pajagua/recolector-de-frutas/vision/README.md

# Visión – cámaras estéreo (PC)

```
cd vision
python -m venv .venv
.venv\Scripts\activate
pip install -r requirements.txt
python scripts/01_probar_camaras.py        # ver las dos cámaras
python scripts/02_capturar_calibracion.py  # fotos del damero para la stereo calibration
```

Índices de cámara, resolución y tamaño del damero: `config/camaras.yaml`.

| Ruta | Qué va |
|---|---|
| `src/citribot_vision/` | código reutilizable (cámaras, calibración, detección, triangulación) |
| `scripts/` | scripts numerados por etapa |
| `data/calibracion/` | resultados de la calibración (matrices) |
| `data/calibracion_imagenes/`, `data/capturas/` | fotos (Git las ignora, solo se guarda la carpeta) |

## Montaje de las cámaras

Las dos **Logitech C270** van en un mástil fijo a la base (CAD: `cad/solidworks/01_Base_J0/CB-150_Modulo_Camaras.SLDASM`, detalle en
[cad/solidworks/README.md §6.11](../cad/solidworks/README.md#611-cámaras-estéreo-cb-150--v71)). Valores nominales en `config/camaras.yaml` (`montaje`).

- Soporte **StereoVision_03** (STL en `cad/imprimir/01_Base_J0/`: base CB-156 + 2 tapas CB-157): cada C270 se cuelga con su pinza; **71 mm entre lentes**, paralelas, a ≈ 661 mm sobre el tablero y a 565 mm del centro de la esfera de trabajo. A esa distancia, en 720p la esfera queda ≈ 1° más alta que el campo vertical (se pierden ≈ 9 mm arriba y abajo): usar 640 × 480, que ve más en vertical, o verificarlo con el damero.
- Para calibrar el par estéreo alcanza con el soporte solo (no hace falta el mástil): la calibración estéreo depende únicamente de cómo quedan las cámaras entre sí. Después no hay que moverlas dentro del soporte.
- **Pose de observación del brazo**: J3 retraído y J2 = −45°. En otras poses la herramienta tapa parte de la esfera.
- Sacar las fotos con el robot quieto: las dos webcams no están sincronizadas.
- Fijar exposición y balance de blancos, y usar MJPEG o puertos USB distintos para no saturar el ancho de banda.
- Medir el campo de visión real con el damero (en 720p la C270 puede recortar el sensor; en 640 × 480 suele ver más en vertical).
- Calibración cámara → robot: damero en la brida de E3, en varias poses conocidas del brazo.
- **Pruebas sin el brazo**: la pieza CB-158 (`cad/imprimir/12_Pruebas/CB-158_Adaptador_Rotula_Bola12.stl`) trae una bola de Ø11,8 mm que entra directo en la rótula del trípode, en lugar del perno M6 original. El cuello (Ø4,8) es macizo. Usa los mismos 4 × M3x12 que el adaptador del mástil, así que después se cambia sin tocar las cámaras ni la calibración estéreo.
