pajagua/recolector-de-frutas/entregas/README.md

# Entregas parciales

Copia de lo que se entregó en cada etapa del curso. Es **historial**: no se edita. Las versiones vigentes de cada cosa están en las carpetas principales del repo.

| Carpeta | Tema | Contenido |
|---|---|---|
| `entrega_05/` | Control en lazo abierto | Sketches Arduino de la cintura, scripts MATLAB, notebook de Colab, informe `control_lazo_abierto.md` |
| `entrega_06/` | Control en lazo cerrado | Guía, modelado e identificación del motor (`DatosMotor.sid`), PID de posición y velocidad, análisis de torque de la ventosa, soporte U de la muñeca, notebook del grupo |
| `entrega_07/` | Prototipo con motores GA25-370 | Piezas modificadas del brazo Mrk1 (STL y 3MF para imprimir) |
