pajagua/recolector-de-frutas/docs/sistemas_de_referencia.md

# Sistemas de referencia del brazo (Denavit-Hartenberg)

En el CAD hay un sistema de coordenadas por articulación, con la convención de Denavit-Hartenberg estándar: **z<sub>i</sub> es el eje de la articulación i+1** y x<sub>i</sub> va por la normal común entre z<sub>i−1</sub> y z<sub>i</sub>. Cada sistema está dentro de la pieza del eslabón al que pertenece, así que se mueve con él cuando se mueven las articulaciones.

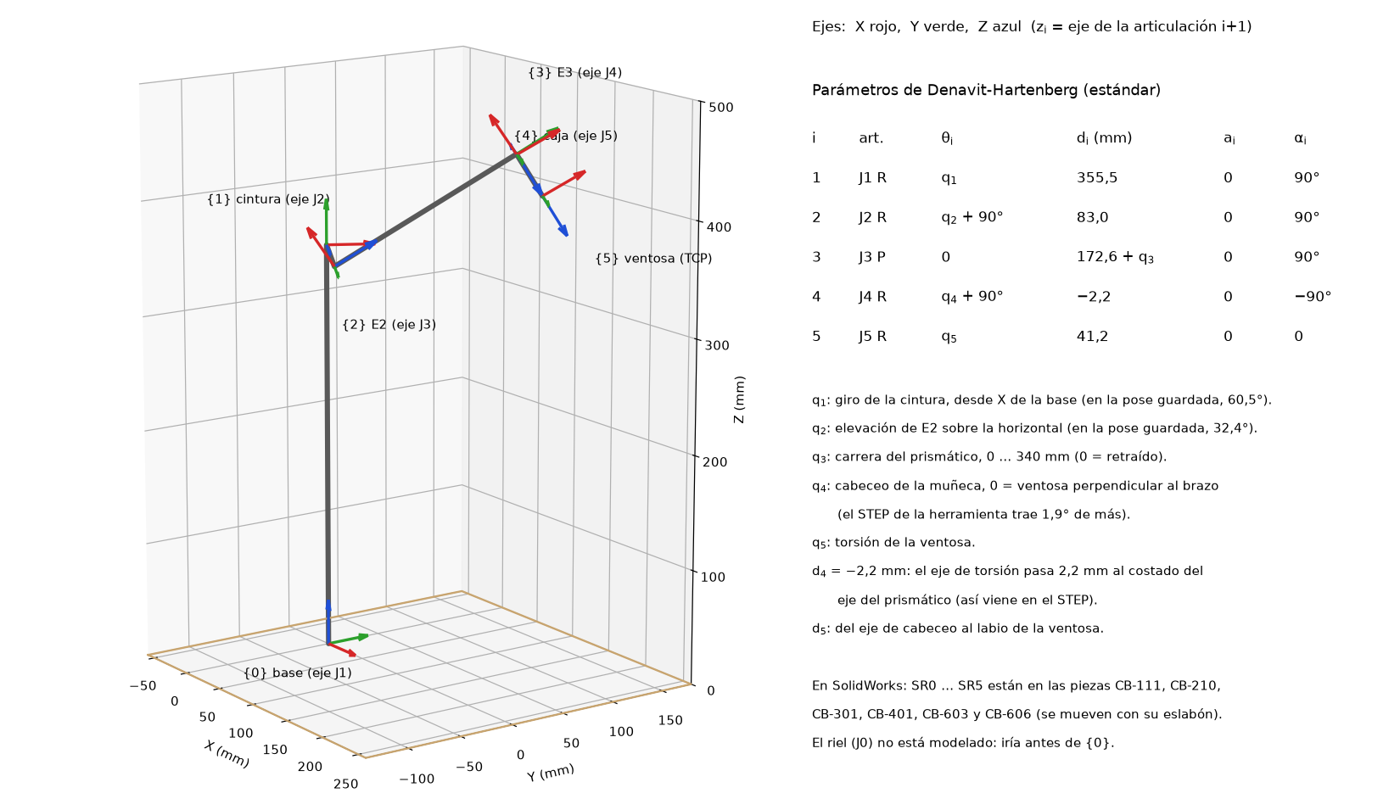
[picture p16: cad/solidworks/06_Imagenes/CB-000_Sistemas_Referencia_DH.png]
Sistemas de referencia DH


## Dónde están en SolidWorks

| Sistema | Pieza (eslabón) | z | Origen |
|---|---|---|---|
| `SR0_base_eje_J1` | CB-121 placa fija de J1 (base, fija) | eje J1, hacia arriba | sobre el eje J1, en la cara de arriba del tablero (origen de CB-000) |
| `SR1_cintura_eje_J2` | CB-210 torre (gira con J1) | eje J2 | cruce de J1 y J2 (z = 355,5) |
| `SR2_E2_eje_J3` | CB-301B E2 (gira con J2; en la variante A, CB-301) | eje del prismático, hacia la herramienta | cruce de J2 y el prismático (83 mm al costado de J1) |
| `SR3_E3_eje_J4` | CB-421B tubo interior = E3 (desliza con J3; en la variante A, el tubo CB-401) | eje de cabeceo de la muñeca | cruce del prismático y el eje de cabeceo |
| `SR4_caja_eje_J5` | CB-603 caja de torsión (cabecea con J4) | eje de torsión, hacia la ventosa | cruce del eje de cabeceo y el de torsión |
| `SR5_ventosa_TCP` | CB-606 eje hueco (gira con J5) | igual que z<sub>4</sub> | labio de la ventosa (punto de trabajo) |

Para verlos: **Ver → Ocultar/mostrar → Sistemas de coordenadas**. En cada pieza aparecen en el árbol de operaciones. Al guardar una pieza como STL, en Opciones se puede elegir uno de estos sistemas como **sistema de coordenadas de salida**: así el STL queda con el origen en la articulación, que es lo que piden los bloques *File Solid* de Simscape.

## Parámetros DH

| i | Articulación | θ<sub>i</sub> | d<sub>i</sub> (mm) | a<sub>i</sub> (mm) | α<sub>i</sub> |
|---|---|---|---|---|---|
| 1 | J1 cintura (R) | q<sub>1</sub> | 355,5 | 0 | 90° |
| 2 | J2 hombro (R) | q<sub>2</sub> + 90° | 83,0 | 0 | 90° |
| 3 | J3 prismático (P) | 0 | 172,6 + q<sub>3</sub> | 0 | 90° |
| 4 | J4 cabeceo (R) | q<sub>4</sub> + 90° | −2,2 | 0 | −90° |
| 5 | J5 torsión (R) | q<sub>5</sub> | 41,2 | 0 | 0 |

- q<sub>1</sub>: giro de la cintura medido desde el eje X de la base. Cuando se midió valía 60,5°.
- q<sub>2</sub>: elevación de E2 sobre la horizontal. Cuando se midió valía 32,4°.
- q<sub>3</sub>: carrera del prismático, 0 … 340 mm (0 = retraído). 172,6 mm = 105 (eje J2 → cara de la brida) + 67,6 (brida → eje de cabeceo).
- q<sub>4</sub>: cabeceo de la muñeca, 0 = ventosa perpendicular al brazo. El STEP de la herramienta trae 1,9° de más (en el CAD θ<sub>4</sub> = 91,9°).
- q<sub>5</sub>: torsión de la ventosa.
- d<sub>4</sub> = −2,2 mm: el eje de torsión pasa 2,2 mm al costado del eje del prismático (así viene en el STEP de la herramienta).
- d<sub>5</sub> = 41,2 mm: del eje de cabeceo al labio de la ventosa.
- Los valores salen de la geometría del CAD (`Marcos.cs`). Las normales comunes miden menos de 0,1 mm, así que todos los ejes se cruzan como pide la convención.
- El riel (J0) todavía no está modelado. Cuando lo esté, es una articulación prismática más, antes de {0}.

## Alcance con estos números

Con la ventosa alineada con el brazo (cabeceo −90°), el labio queda a ρ = 105 + q<sub>3</sub> + 67,6 + 41,2 = **213,8 … 553,8 mm** del eje J2. La esfera pide 254,0 … 554,0 mm (`docs/espacio_de_trabajo.md`): **el lado lejano queda justo en el límite, 0,2 mm corto**. Antes se documentaba un labio a 65,5 mm del eje de cabeceo, que estaba mal.

## Para simular en MATLAB / Simulink

- Para exportar conviene usar el **brazo solo**, `cad/solidworks/13_Brazo_Solo/CB-001_Brazo_Solo.SLDASM`: sin base de madera, electrónica, cámaras ni motores, con las mismas articulaciones y los mismos sistemas SR0 … SR5.

- **Simscape Multibody Link** (complemento de SolidWorks) exporta el ensamblaje y arma las articulaciones a partir de las **relaciones de posición**. En CB-000 J1, J2 y J3 ya las tienen. La herramienta (J4 y J5) todavía es un bloque rígido: para simular la muñeca hay que articularla con relaciones (concéntrica en el eje de cabeceo y en el eje hueco).
- Para armar el modelo a mano con bloques *File Solid* + *Revolute/Prismatic Joint*, exportar cada eslabón como STL con su sistema SR*i* de salida y usar la tabla DH de arriba para los *Rigid Transform*.
