pajagua/recolector-de-frutas/entregas/entrega_06/SerieKS.md

Rotary One-touch Fittings
Standard Type/High Speed Type
KS/KX
Series
Cassette
The male connector is equipped with a
Slide bearing
“tuberotation prevention mechanism”.
Smooth operation and longer life from an  Series KS      Blue
oil containing slide bearing.
Series KX      Blue
Rotary seal
A special rotary seal minimizes friction while
| providing an excellent seal. | | | | Series KX (High speed) | | | | |
| --- | --- | --- | --- | --- | --- | --- | --- | --- |
Scraper
Holder
Prevents chips from intruding
Standard nickel plated allows copper-free applications.
into bearing parts.
| Ball bearing | | Rotary seal | | | | | | |
| --- | --- | --- | --- | --- | --- | --- | --- | --- |
X ring shape minimizes
| A ball bearing ensures low torque rotation. | | | | | | Ball bearing | | |
| --- | --- | --- | --- | --- | --- | --- | --- | --- |
friction while providing an
excellent seal. Seal is fire
A ball bearing ensures low torque
| | Series KS  | a n d  s h | o ck  p r o o f  flu o r in | e | | | | |
| ---- | --- | --- | --- | --- | --- | --- | --- | --- |
| Stud | | | | | | rotation. Stainless steel 440C  | | |
| | | ru b b e | r.  P ro v e s  a g a in s  | t  h igh  | | improves corrosion resistance.  | | |
| | (Standard) | friction heat in high speed  | | | | | | |
Standard nickel plated allows copper-free applications.
| | | rotation and longer life. | | ∗ Other parts’ specifications are same as those  | | | | |
| --- | --- | --- | --- | --- | --- | --- | --- | --- |
| Thread sealant is standard. | | | | of Series KS. | | | | |
Low torque rotation style
Applicable Tubing
Rotary One-touch fittings Tubing material Note) Nylon, Soft nylon, Polyurethane
| | Tubing O.D. | | | | | ø4, ø6, ø8, ø10, ø12 | | |
| --- | --- | --- | --- | --- | --- | --- | --- | --- |
Applicable to use for
Note) Use caution about the max. operating pressure for soft nylon and polyurethane.
oscillating and rotating
sections in robots.
Specifications
Copper-free specifications
| | Fluid | | | | | Air | | |
| --- | --- | --- | --- | --- | --- | --- | --- | --- |
| Brass parts are all  | Maximum operating pressure | | | | | 1.0 MPa | | |
Operating vacuum pressure
| electroless nickel plated. | | | | | | –100 kPa | | |
| --- | --- | --- | --- | --- | --- | --- | --- | --- |
Proof pressure
3.0 MPa
| | Ambient and fluid temperature | | | | –5 to 60°C (No freezing) | | | |
| --- | --- | --- | --- | --- | --- | --- | --- | --- |
Thread seal is standard.
JIS B 0203 (Taper thread for piping),
Thread
JIS B 0209, class 2 (Metric coarse thread)
Rotating Torque/Allowable Number of Rotations
Applicable tubing O.D.
| | | | | ø4  | ø6  | ø8  | ø10 | ø12 |
| --- | --- | --- | --- | --- | --- | --- | --- | --- |
Rotating torque (N·m) Note)
| | | | | 0.006 | 0.012 | 0.014 | 0.020 | 0.022 |
| --- | --- | --- | --- | ----- | ----- | ----- | ----- | ----- |
| | | | Series KS | 8.4 | 8.4 | 6.7 | 5 | 4.2 |
Allowable number of rotations
| | | | Series KX | 25  | 20  | 20  | 16.7 | 16.7 |
| --- | --- | --- | --- | --- | --- | --- | ---- | ---- |
Note) Rotating torque under pressure 0.5 MPa
Principal Parts Material
Male elbow
| | Model  | | | | Series KS | | Series KX | |
| --- | --- | --- | --- | --- | --- | --- | --- | --- |
| | Body | | | | | PBT | | |
| | Stud, Holder, Guide | | | C3604BD (Electroless nickel plated), Stainless steel 304 | | | | |
Male connector
Stainless steel (Stainless steel 304) (1) (Retainer (C) of
Chuck, Retainer
Series KX: C3604BD (electroless nickel plated))
| | Collet, Release button, Snap ring | | | | | Polyacetal | | |
| --- | --- | --- | --- | --- | --- | --- | --- | --- |
| | O-ring, Packing | | | | | NBR | | |
| | Rotary seal | | | | NBR | | FPM | |
| | Slide bearing | | | Oil-containing polyacetal | | | | — |
| | Scraper | | | | — | | NBR | |
| | Ball bearing | | | | Bearing steel | | Stainless steel 440C | |
| | Gasket | | | | Stainless steel (Stainless steel 304), NBR | | | |
15-2-38

KS/KX
Series
Rotary One-touch Fittings
Series KS/Series KX
Applicable tubing O.D. (mm)
Model Connection thread
ø4 ø6 ø8 ø10 ø12
Male connector
M5 x 0.8
KSH
KXH
M6 x 1
R18
K(cid:1)
R14
M(cid:1)
R38
R12
H(cid:1)
Male elbow
KSL
M5 x 0.8 D(cid:1)
KXL
M6 x 1
MS
R18
T(cid:1)
R14
VMG
R38
R12
Precautions
Be sure to read before handling. Refer to pages 15-18-3 to 15-18-4 for
Safety Instructions and Common Precautions on the products mentioned
in this catalog, and refer to pages 15-1-10 to 15-1-11 for Precautions on
every series.
Caution
1. Implement the tube piping in such a way that laterial load should not be applied on the
ball bearings, otherwise it may adversely affect the life expectancy.
A flexible polyurethane tube is recommended when the lateral load is applied.
15-2-39

KS/KX
Series
Male connector: KSH (Standard)
H
| <M5, M6> | Applicable  | Connection | | | | | Min. Effective area | | | <M5, M6> | |
| --- | --- | --- | ----- | --- | ---- | --- | --- | --- | --- | --- | --- |
| | tubing O.D. | thread | Model | (width | | M | (mm2) | Weight | | | |
| | | | | across D1 | D2 L | A | port | (g) | | | |
| | (mm) | R | | flats) | | | size NylonUrethane  | | | | |
Applicable
M5 x 0.8
| | | | KSH04-M5 | | 36.5  | 33  | | 9 | | | tubing |
| --- | --- | --- | --- | --- | ----- | --- | --- | --- | --- | --- | --- |
| | | M6 x 1 | KSH04-M6 | 8 10.4 | 12 37 | 16  | 2.5 4.0 | 4.0 | | | |
4
| | | 18 | KSH04-01S | 12  | 38 | 34 | | 14  | | | |
| --- | --- | --- | --- | --- | ---- | ---- | --- | --- | --- | --- | --- |
| | | M5 x 0.8 | KSH06-M5  | | 37.5 | 33.5 | 2.5 4.0 | 4.0 | | | |
12
| | | M6 x 1 | KSH06-M6  | 8 | 38 | 34 | 3 5.6  | 5.6 | | | |
| --- | --- | --- | --- | --- | ----- | --- | --- | --- | --- | --- | --- |
| | | 6 | | 12.8 | 14 | 17 | | | | | |
| | | 18 | KSH06-01S | | 39.5  | 35.5 | | 17 | | | |
| | | | | 14 | | | 4 10.4 | 10.4 | | | |
| | | 14 | KSH06-02S | | 42.5  | 36.5 | | 23 | | | |
| | | 18 | KSH08-01S | | 44 | 40 | | 23 | | | |
| <R> | | 8 14 | KSH08-02S | 17 15.2 | 17 47 | 41 18.56 | 26.1 | 18.0 29 | | | |
| | | 38 | KSH08-03S | | 48 | 41.5 | | 37 | | | |
| | | 14 | KSH10-02S | | 54 | 48 | | 55 | | Connection thread | |
| | | 10 38  | KSH10-03S | 22 18.5 | 22 55 | 48.5 21  | 7 36.3 | 29.5 63 | | | |
| | | 12 | KSH10-04S | | 57.5  | 49.5 | | 81 | | <R> | |
| | | 38 | KSH12-03S | | 57 | 50.5 | | 75 | | | |
| | | 12 | | 24 20.9 | 24 | 22 | 8 46.1 | 16.1 | | | |
| | | 12 | KSH12-04S | | 60 | 52 | | 92 | | | Applicable |
| | | | | ∗ Reference dimensions after R thread installation. | | | | | | | tubing |
∗
 A
Connection thread
(With seal)
Male Connector: KXH (High speed)
H
| <M5, M6> | Applicable  | Connection | | | | | Min. Effective area | | | <M5, M6> | |
| --- | --- | --- | --- | --- | ----- | --- | --- | --- | --- | --- | --- |
| | tubing O.D. | thread | Model | (width D1 | D2 L  | A M | port (mm2) | Weight | | | |
| | | | | across | | | | (g) | | | |
| | (mm) | R | | flats) | | | sizeNylonUrethane | | | | |
| | | M5 x 0.8 | KXH04-M5  | | 38.5  | | | | | | Applicable tubing |
| | | | | 8 | | 35  | | 11 | | | |
| | | 4 M6 x 1 | KXH04-M6  | 10.4 | 13 39 | 16  | 2.5 4.0 | 4.0 | | | |
| | | 18 | KXH04-01S | 12 | 40 | 36  | | 16 | | | |
| | | M5 x 0.8 | KXH06-M5  | | 39.5  | | 2.5 4.0 | 4.0 | | | |
| | | | | 8 | | 36  | | 15 | | | |
| | | M6 x 1 | KXH06-M6  | | 40 | | 3 5.6 | 5.6 | | | |
| | | 6 | | 12.8 | 15 | 17  | | | | | |
| | | 18 | KXH06-01S | | 42 | 38  | | 20 | | | |
| | | | | 14 | | | 4 10.4 | 10.4 | | | |
| | | 14 | KXH06-02S | | 45 | 39  | | 26 | | | |
| | | 18 | KXH08-01S | | 46 | 42  | | 28 | | | |
<R>
| | | 8 14 | KXH08-02S | 17 15.2 | 18 49 | 43 18.5 | 6 26.1 | 18.0 34 | | | |
| --- | --- | ---- | --- | --- | ----- | --- | --- | --- | --- | --- | --- |
| | | 38 | KXH08-03S | | 50 | 44 | | 42 | | | |
Connection
| | | 14  | KXH10-02S | | 58  | | | 68  | thread | | |
| --- | --- | --- | --- | --- | --- | --- | --- | --- | --- | --- | --- |
52
| | | 10 38 | KXH10-03S | 22 18.5 | 23.5 59 | 21  | 7 36.3 | 29.5 76 | | | |
| --- | --- | ----- | --- | --- | --- | --- | --- | --- | --- | --- | --- |
| | | 12 | KXH10-04S | | 62 | 53  | | 94 | | | |
<R>
| | | 38  | KXH12-03S | | 60  | 54  | | 88 | | | |
| --- | --- | --- | --- | --- | --- | --- | --- | ---- | --- | --- | --- |
| | | 12  | | 24 20.9 | 26  | 22  | 8 46.1 | 46.1 | | | |
| | | 12  | KXH12-04S | | 63  | 55  | | 105  | | | |
| | | | | ∗ Reference dimensions after R thread installation. | | | | | | | Applicable tubing |
∗
 A
Connection thread
(With seal)
15-2-40

KS/KX
Series
Rotary One-touch Fittings
Male Elbow: KSL (Standard)
H
<M5, M6> A p p l ic a b le Co n n e c tion M in . Effe ctiv e  a rea <M5, M6>
| | t u b in g | O .D . | | (width | | | (m m | 2 ) Weight | | | |
| --- | --- | --- | --- | --- | ----- | ---- | --- | --- | --- | --- | --- |
| | | t h re | a d Model | across D1 D2 | L1 L2 | A M  | po rt | | | | |
| | (mm) | R | | flats) | | | size | (g) | | | |
| | | | | | | | Nylon Urethane | | | | |
| | | M5 x 0.8 | KSL04-M5  | 8 | 20.5  | | | | | | |
| | | | | | | 22 | | 9 | | | |
| | 4 | M6 x 1 | KSL04-M6  | 10.4 12 | 21 21 | 16 | 2.5 3.5 | 3.5 | | | |
| | | 18 | | 12 | | 23.5 | | 14 | | | |
| | | | KSL04-01S | | 22 | | | | | | |
| | | M5 x 0.8 | | | 21 | 23.5 | 2.5 3.5 | 3.5 | | | |
| | | | KSL06-M5  | 8 | | | | 12 | | | |
| | | M6 x 1 | | | 21.5  | 24 | 3 5.0 | 5.0 | | | |
| | 6 | | KSL06-M6  | 12.8 14 | 23 | 17 | | | | | |
| | | 18 | KSL06-01S | | 23 | 25.5 | | 17 | | | |
| | | | | 14 | | | 4 8.6 | 8.6 | | | |
| | | 14 | KSL06-02S | | 26 | 26.5 | | 23 | | | K(cid:1) |
| | | 18 | KSL08-01S | | 26.5  | 30 | | 23 | | | |
| <R> | | | | | | | | | | Applicable tubing | |
8 14 KSL08-02S 17 15.2 17 26 29.5 31 18.5 6 21.6 14.9 29 M(cid:1)
| | | 38  | KSL08-03S | | 31 | 32 | | 38  | | | |
| --- | --- | --- | --- | --- | --- | ----- | --- | --- | --- | --- | --- |
| | | 14  | KSL10-02S | | 34 | 37.5  | | 56  | | | |
| | | | | | | | | | | Connection thread | H(cid:1) |
| | 10  | 38  | KSL10-03S | 22 18.5 22 | 31.5 35 | 38 21 | 7 30.5 25.0 | 64  | | | |
| | | 12  | KSL10-04S | | 38 | 39.5  | | 82  | <R> | | |
D(cid:1)
| | | 38  | KSL12-03S | | 36.5 | 40.5 | | 76  | | | |
| --- | --- | --- | --- | --- | ---- | ---- | --- | --- | --- | --- | --- |
| | 12  | | | 24 20.9 24 | 34 | 22 | 8 35.1 35.1 | | | | |
| | | 12  | KSL12-04S | | 39.5 | 42 | | 93  | | | |
| | | | | ∗ Reference dimensions after R thread installation. | | | | | | | MS  |
T(cid:1)
VMG
∗
Applicable tubing
Connection thread
(With seal)
Male Elbow: KXL (High speed)
| | Applicable  | Connection | | H | | | Min. Effective area | | | | |
| --- | --- | --- | --- | --- | ----- | --- | --- | --- | --- | --- | --- |
| <M5, M6> | | | | (width | | | | Weight | <M5, M6> | | |
| | tubing O.D. | thread | Model | D1 D2 | L1 L2 | A M | port (mm2) | | | | |
| | | | | across | | | | (g) | | | |
| | (mm) | R | | flats) | | | size Nylon | Urethane | | | |
| | | M5 x 0.8 | KXL04-M5  | | 22.5  | | | | | | |
| | | | | 8 | | 24 | | 11 | | | |
| | 4 | M6 x 1 | KXL04-M6  | 10.4 13 | 22 23 | 16 | 2.5 3.5 | 3.5 | | | |
| | | 18 | KXL04-01S | 12 | 24 | 25 | | 16 | | | |
| | | M5 x 0.8 | KXL06-M5  | | 23.5  | | 2.5 3.5 | 3.5 | | | |
| | | | | 8 | | 26 | | 15 | | | |
| | | M6 x 1 | KXL06-M6  | | 24 | | 3 5.0 | 5.0 | | | |
| | 6 | | | 12.8 15 | 24 | 17 | | | | | |
| | | 18 | KXL06-01S | | 25 | 28 | | 20 | | | |
| | | | | 14 | | | 4 8.6 | 8.6 | | | |
| | | 14 | KXL06-02S | | 28 | 29 | | 26 | | | |
| | | 18 | KXL08-01S | | 29 | 32 | | 28 | | | |
| <R> | 8 | 14 | KXL08-02S | 17 15.2 18 | 27 32 | 33 18.5 | 6 21.6 | 14.9 34  | | | |
Applicable tubing
| | | 38  | KXL08-03S | | 33  | 34  | | 43  | | | |
| --- | --- | --- | --- | --- | --- | --- | --- | --- | --- | --- | --- |
| | | 14  | KXL10-02S | | 38  | | | 69  | | | |
42
| | 10  | 38  | KXL10-03S | 22 18.5 23.5 | 32 39 | 21  | 7 30.5 | 25.0 77 | | | |
| --- | --- | --- | --- | --- | ----- | --- | --- | --- | --- | --- | --- |
| | | 12  | KXL10-04S | | 42 | 43  | | 95 | | Connection thread | |
| | | 38  | KXL12-03S | | 40 | 44  | | 89 | | | |
| | 12  | | | 24 20.9 26 | 35 | 22  | 8 35.1 | 35.1 | | | |
| | | 12  | KXL12-04S | | 43 | 45  | | 106 | <R> | | |
∗ Reference dimensions after R thread installation.
Applicable tubing
Connection thread
15-2-41

Inch-size Rotary One-touch Fittings
Standard Type
KS
Series
Applicable Tubing: Inch Size
| Slide bearing | | | Cassette (Red) |
| --- | --- | --- | --- |
Smooth operation and longer life from an  The male connector is
oil containing slide bearing. equipped with a “tube rotation
| Rotary seal | | prevention mechanism.” | |
| --- | --- | --- | --- |
A special rotary seal minimizes friction
while providing an excellent seal.
Holder
Standard nickel plated allows copper-free
applications.
Ball bearing
A ball bearing ensures low torque rotation.
Stud
Standard nickel plated allows copper-free
applications.
Thread seal is standard.
| Low-torque rotation style  Applicable Tubing | | | |
| --- | --- | --- | --- |
rotary One-touch fittings
| | Tubing materialNote) | Nylon, Soft nylon, Polyurethane | |
| --- | --- | --- | --- |
| | Tubing O.D. | ø532", ø14", ø516", ø38" | |
Applicable to use for
Note)Monitor max.operating pressure for soft nylon and polyurethane tubing.
oscillating and rotating
sections in robots.
Specification
Applicable to non-copper
| | Fluid | | Air |
| --- | ----- | --- | --- |
type (With electroless nickel
| | Maximum operating pressure | | 1.0 MPa  |
| --- | --- | --- | --- |
| plated) | Operating vacuum pressure  | | –100 kPa |
| | Proof pressure | | 3.0 MPa  |
Thread seal is standard.
| | Ambient and fluid temperature | –5 to 60°C (No freezing) | |
| --- | --- | --- | --- |
ANSI/ASMEB1.20.1-1983 (NTP thread)
Thread
JIS B 0212 2A, Class 2B (UNF thread)
Rotating Torque/Allowable Number of Rotations
| | Applicable tubing O.D. | ø5 32" | ø1 4" ø5 16" ø3 8" |
| --- | --- | --- | --- |
| | Rotating torque (N·m)Note) | 0.006  | 0.012 0.014 0.020  |
| | Allowable number of rotations (S-1) | 8.3 | 8.3 6.7 5 |
Note) Rotating torque under pressure 0.5 MPa
Male elbow
| Male connector Principal Parts Material | | | |
| --- | ---- | --- | --- |
| | Body | | PBT |
Stud, Holder, Guide Stainless steel 304, C3604BD (With electroless nickel plated)
| | Chuck, Retainer | Stainless steel 304 | |
| --- | --- | --- | --- |
| | Collet, Release button, Snap ring | | Polyacetal  |
| | O-ring, Packing | | NBR |
| | Rotary seal | | NBR |
| | Slide bearing | Oil-containing polyacetal | |
| | Scraper | | — |
| | Ball bearing | Bearing steel | |
| | Gasket | Stainless steel 304, NBR  | |
15-4-36

KS
Series
Inch-size Rotary One-touch Fittings
Series KS
Applicable tubing O.D. (inch)
Model Connection thread
ø 5 3 2 " ø 1 4 " ø 5 1 6 " ø 3 8 "
Male connector
10-32 UNF
KSH
NPT18
NPT14
K(cid:1)
NPT38
Male elbow M(cid:1)
10-32 UNF
KSL
NPT18 H(cid:1)
NPT14 D(cid:1)
NPT38
MS
T(cid:1)
VMG
Precautions
Be sure to read before handling. Refer to pages 15-18-3 to 15-18-4 for
Safety Instructions and Common Precautions on the products mentioned
in this catalog, and refer to pages 15-1-10 to 15-1-11 for Precautions on
every series.
Caution
1.Implement the tube piping in such a way that the lateral load should not be applied.
Although ball bearing is adopted, however if the lateral load were applied on it, it may
adversely affect the life expectancy. A flexible polyurethan tube is recommended when
the lateral load is applied.
15-4-37

KS
Series
Male Connector: KSH (Standard)
| | Applicable Connection  | | | H | | | | Effective area | | | |
| ----- | --- | --- | --- | --- | --- | ---- | ----- | --- | --- | --- | --- |
| <UNF> | | | | | | | | Min. | <UNF>  | | |
| | tubing | thread | | (Width | | | ∗ | p o r t  (mm2) | Weight | | |
| | O | . D . U N F | Model | a c ro s s | D1 D2 | L | A  M  | | (g) | | |
| | | | | f la ts )  | | | | s iz e NylonUrethane  | | Applicable | |
| | ( in | c h ) N PT | | | | | | | | | |
| | | 10-32 UNFKSH03-32 | | 8 | | | | | 9 | tubing | |
| | 532 | | | | 10.4 12 | 36.5 | 33 16 | 2.5 4.0 4.0 | | | |
| | | 18 | KSH03-34S12.7 | | | | | | 14 | | |
38.5 34.5
| | | 1 | K S H 0 | 7 - 3 4 S | | | | | 1 7 | | |
| --- | --- | --- | --- | --- | --- | --- | --- | --- | --- | --- | --- |
| | 14  | 8 | | 14.2913.2 | 14  | 3 9 . 5 | 3 5 . 5 17 | 4 13.4 10.4 | | | |
| | | 1 | K S H 0 | 7 - 3 5 S | | | | | 2 3 | | |
| | | 4 | | | | 4 2 . 5 | 3 6 . 5 | | | | |
| | | 1 | K S H 0 | 9 - 3 4 S | | 4 4 | 4 0 | | 2 3 | | |
| | 516 | 8 | | 17.4615.2 | 17  | | 18.5 | 6 26.1 18.0 | | | |
| | | 1 | K S H 0 | 9 - 3 5 S | | 4 7 | 4 1 | | 2 9 | | |
4
| | | 1 | K S H 1 | 1 - 3 5 S | | 5 4 | 4 8 | | 5 5 | | |
| --- | --- | --- | --- | --- | --- | --- | ----- | --- | --- | --- | --- |
| | 38  | 4 | | 22.2317.9 | 22  | | 21 | 7 36.3 29.5 | | | |
| | | 3 | K S H 1 | 1 - 3 6 S | | 5 5 | 4 8.5 | | 6 3 | | |
8
∗Reference dimensions after NPT thread installation.
Connection thread
| <NPT> | | | | | | | | | <NPT> | | |
| ----- | --- | --- | --- | --- | --- | --- | --- | --- | ----- | --- | --- |
Applicable
tubing
Connection thread
(With seal)
Male Elbow: KSL (Standard)
| | Ap p | l i c a b le Co n n ec | t ion  | H | | | | Ef fe c tiv e | a r e a | | |
| --- | ---- | --- | --- | --- | --- | --- | --- | --- | --- | --- | --- |
<UNF> t u b in g t h r e a d (W i d t h ∗ M i n .   We ig ht <UNF>
| | | | Model | | D1 D2 | L1 L2 | A  M | p o r t ( m m 2 | ) | | |
| --- | ---- | --- | --- | --- | --- | ----- | --- | --- | --- | --- | --- |
| | O | . D . U N F | | a c r o s s | | | | s i z e | (g ) | | |
| | ( in | c h ) N P T | | f la t s )  | | | | N y l o n U r e | t h a n e  | | |
| | | 10-32 UNFKSL03-32 | | 8 | | 20.5  | 22 | | 9 | | |
| | 532  | | | | 10.4 12 | 21 | 16 | 2.5 3.5 3.5 | | | |
| | | 18 | KSL03-34S12.7 | | | 22 | 23.5 | | 14 | | |
| | | 1 8 | K S L 0 7 | - 3 4 S | | 2 3 | 2 5 . 5 | | 1 7 | | |
| | 14 | | | 14.2913.2 | 14 | 23.5  | 17 | 4 8.6 8.6 | | | |
| | | 1 | K S L 0 7 | - 3 5 S | | 2 6 | 2 6 . 5 | | 2 3 | | |
4
| | | 1 8 | K S L 0 9 | - 3 4 S | | 2 6  | . 5 3 0 | | 2 3 | | |
| --- | --- | --- | --- | --- | --- | ---- | --- | --- | --- | --- | --- |
| | 516 | | | 17.4615.2 | 17  | 26 | 18.5 | 6 21.6 14.9 | | | |
| | | 1 4 | K S L 0 9 | - 3 5 S | | 2 9  | . 5 3 1 | | 2 9 | | |
| | | 1 4 | K S L 1 1 | - 3 5 S | | 3 4  | 3 7 | | 5 6 | | |
| | 38  | | | 22.2317.9 | 22  | 31.5 | 21 | 7 30.5 25.0 | | | |
| | | 3 8 | K S L 1 1 | - 3 6 S | | 3 5  | 3 8 | | 6 4 | | Applicable tubing |
∗Reference dimensions after NPT thread installation.
<NPT>
Connection thread
<NPT>
Applicable tubing
Connection thread
(With seal)
15-4-38

Safety Instructions
These safety instructions are intended to prevent a hazardous situation and/or
equipment damage. These instructions indicate the level of potential hazard by labels of
"Caution", "Warning" or "Danger". To ensure safety, be sure to observe ISO 4414 Note 1),
JIS B 8370 Note 2) and other safety practices.
Caution :
Operator error could result in injury or equipment damage.
Warning :
Operator error could result in serious injury or loss of life.
Danger :
In extreme conditions, there is a possible result of serious injury or loss of life.
Note 1) ISO 4414: Pneumatic fluid power--General rules relating to systems.
Note 2) JIS B 8370: General Rules for Pneumatic Equipment
Warning
1. The compatibility of pneumatic equipment is the responsibility of the person
who designs the pneumatic system or decides its specifications.
Since the products specified here are used in various operating conditions, their compatibility for the
specific pneumatic system must be based on specifications or after analysis and/or tests to meet your
specific requirements. The expected performance and safety assurance will be the responsibility of the
person who has determined the compatibility of the system. This person should continuously review
the suitability of all items specified, referring to the latest catalog information with a view to giving due
consideration to any possibility of equipment failure when configuring a system.
2.Only trained personnel should operate pneumatically operated machinery
and equipment.
Compressed air can be dangerous if an operator is unfamiliar with it. Assembly, handling or repair of
pneumatic systems should be performed by trained and experienced operators.
3. Do not service machinery/equipment or attempt to remove components until
safety is confirmed.
1. Inspection and maintenance of machinery/equipment should only be performed once measures to
prevent falling or runaway of the driver objects have been confirmed.
2. When equipment is to be removed, confirm the safety process as mentioned above. Cut the supply
pressure for this equipment and exhaust all residual compressed air in the system.
3. Before machinery/equipment is restarted, take measures to prevent shooting-out of cylinder piston
rod, etc.
4. Contact SMC if the product is to be used in any of the following conditions:
1. Conditions and environments beyond the given specifications, or if product is used outdoors.
2. Installation on equipment in conjunction with atomic energy, railway, air navigation, vehicles,
medical equipment, food and beverages, recreation equipment, emergency stop circuits, clutch and
brake circuits in press applications, or safety equipment.
3. An application which has the possibility of having negative effects on people, property, or animals,
requiring special safety analysis.
15-18-3

Common Precautions
Be sure to read before handling.
For detailed precautions on every series, refer to main text.
Selection 4. Use clean air
If the compressed air supply is contaminated with chemicals,
Warning
cynthetic materials, corrosive gas, etc., it may lead to break
down or malfunction.
1. Confirm the specifications.
Products represented in this catalog are designed for use in
compressed air appllications only (including vacuum), unless Operating Environment
otherwise indicated. Warning
Do not use the product outside their design parameters.
Please contact SMC when using the products in applications 1. Do not use in environments where the product
other than compressed air (including vacuum). is directly exposed to corrosive gases,
chemicals, salt water, water or steam.
Mounting 2. Do not expose the product to direct sunlight
Warning for an extended period of time.
3. Do not use in a place subject to heavy
1. Instruction manual
vibrations and/or shocks.
Install the products and operate them only after reading the
4. Do not mount the product in locations where it
instruction manual carefully and understanding its contents.
is exposed to radiant heat.
Also keep the manual where it can be referred to as
necessary.
2. Securing the space for maintenance Maintenance
When installing the products, please allow access for Warning
maintenance.
3. Tightening torque 1. Maintenance procedures are outlined in the
When installing the products, please follow the listed torque operation manual.
specifications. Not following proper procedures could cause the product to
malfunction and could lead to damage to the equipment or
Piping machine.
2. Maintenance work
Caution
If handled improperly, compressed air can be dangerous.
Assembly, handling and repair of pneumatic systems should
1. Before piping
be performed by qualified personnel only.
Make sure that all debris, cutting oil, dust, etc, are removed
3. Drain flushing
from the piping.
Remove drainage from air filters regularly. (Refer to the
2. Wrapping of pipe tape
specifications.)
When screwing piping or fittings into ports, ensure that chips
4. Shut-down before maintenance
from the pipe threads or sealing material do not get inside the
piping. Also, when the pipe tape is used, leave 1.5 to 2 thread Before attempting any kind of maintenance make sure the
ridges exposed at the end of the threads. supply pressure is shut of and all residual air pressure is
released from the system to be worked on.
Air Supply 5. Start-up after maintenance and inspection
Apply operating pressure and power to the equipment and
Warning
check for proper operation and possible air leaks. If operation
is abnormal, please verify product set-up parameters.
1. Operating fluid
6. Do not make any modifications to be product.
Please consult with SMC when using the product in
applications other than compressed air (including vacuum). Do not take the product apart.
Regarding products for general fluid, please ask SMC about
applicable fluids.
2. Install an air dryer, aftercooler, etc.
Excessive condensate in a compressed air system may cause
valves and other pneumatic equipment to malfunction.
Installation of an air dryer, after cooler etc. is recommended.
3. Drain flushing
If condensate in the drain bowl is not emptied on a regular
basis, the bowl will over flow and allow the condensate to
enter the compressed air lines.
If the drain bowl is difficult to check and remove, it is
recommended that a drain bowl with the auto-drain option be
installed.
For compressed air quality, refer to “Air Preparation
Equipment” catalog.
15-18-4

Quality Assurance Information
(ISO 9001, ISO 14001)
Reliable quality of products in the global market
To enable our customers throughout  SMC’s quality control system
| the  world | to  use | our  | products  | with  | | | | |
| --- | --- | ---- | --- | ----- | --- | --- | --- | --- |
| even  greater  | confidence,  | | SMC | has | Make customers our  | | | |
first priority, offering
Create new
| obtained certification for international  | | | | | them reliable and  | | | |
| --- | --- | --- | --- | --- | --- | --- | --- | --- |
| | | | | | friendly service.  | | products using the  | |
latest technology,
| standards  | “ISO  | 9001”  | and  | “ISO  | | | and offer the finest  | |
| --- | ----- | --- | ---- | ----- | --- | --- | --- | --- |
| | | | | | Produce the highest  | | products in a | |
14001”,  and  created  a  complete  quality with the  timely manner.
participation of all
employees.
| structure | for  quality  | assurance  | | and  | | | | |
| --- | --- | --- | --- | ---- | --- | --- | --- | --- |
| environmental  | | controls.  | | SMC  | | | | |
Quality policies
| products | pursue | to  | meet | its | | | | |
| --- | --- | --- | --- | ----- | --- | --- | --- | --- |
| customers’  | expectations  | | while  | also  | | | | |
considering company’s contribution in
society.
Market research
Product planning
After service
Sales coordination
| | | | | | | | N | e w p r o d u c t e v a luation |
| --- | --- | --- | --- | --- | --- | --- | --- | --- |
| | | | | | Q u a li t y s y s tem  | E d u c a t io n | R e s e a r ch R | e l i a b i l i t y d e s i g n |
| | | | | | e d u c a t i o n | Tr a in i n g | D e s ig n R | e l i a b i l i t y t e s t i n g |
Q ua lit y  m a n agement system T r a in i n g   o f   D ev e l o p ment N e w   t e c h n i c a l
| | | | | | s u p p l i e r s | P roduction | | |
| --- | --- | --- | --- | --- | --- | --- | --- | --- |
| IS O 9 0 | 0 1 | | | | | | de  | v e l o p m e n t |
Process control
Inspection, testing, etc.
This is an international standard for quality control  Initial production control
and quality assurance. SMC has obtained a large
Quality control activities
number of certifications in Japan and overseas,
providing assurance to our customers throughout
the world.
Environmental management system
ISO 14001
| This  is | an  international  | standard  | | related  to  | | | | |
| --- | --- | --- | --- | --- | --- | --- | --- | --- |
| environmental  | management | | systems  | and | | | | |
| environmental  | inspections. | | While | promoting | | | | |
environmentally friendly automation technology,
SMC is also making diligent efforts to preserve
the environment.
15-18-5

SMC Product Conforming to Inter
SMC products complying with EN/ISO, CSA/UL standards are supporting
CE Mark
The CE mark indicates that machines and components meet essential requirements of all the EC Directives
applied.
It has been obligatory to apply CE marks indicating conformity with EC Directives when machines and
components are exported to the member Nations of the EU.
Once “A manufacturer himself” declares a product to be safe by means of CE marking (declaration of
conformity by manufacturer), free distribution inside the member Nations of the EU is permissible.
(cid:1) CE Mark
SMC provides CE marking to products to which EMC and Low Voltage Directives have been applied, in
accordance with CETOP (European hydraulics and pneumatics committee) guide lines.
(cid:1) As of February 1998, the following 18 countries will be obliged to conform to CE mark legislation
Iceland, Ireland, United Kingdom, Italy, Austria, Netherlands, Greece, Liechtenstein, Sweden, Spain, Denmark,
Germany, Norway, Finland, France, Belgium, Portugal, Luxembourg
(cid:1) EC Directives and Pneumatic Components
• Machinery Directive
The Machinery Directive contains essential health and safety requirements for machinery, as applied to
industrial machines e.g. machine tools, injection molding machines and automatic machines. Pneumatic
equipment is not specified in Machinery Directive. However, the use of SMC products that are certified as
conforming to EN Standards, allows customers to simplify preparation work of the Technical Construction File
required for a Declaration of Conformity.
• Electromagnetic Compatibility (EMC) Directive
The EMC Directive specifies electromagnetic compatibility. Equipment which may generate electromagnetic
interference or whose function may be compromised by electromagnetic interference is required to be immune
to electromagnetic affects (EMS/immunity) without emitting excessive electromagnetic affects (EMI/emission).
• Low Voltage Directive
This directive is applied to products, which operate above 50 VAC to 1000 VAC and 75 VDC to 1500 VDC
operating voltage, and require electrical safety measures to be introduced.
• Simple Pressure Vessels Directive
This directive is applied to welded vessels whose maximum operating pressure (PS) and volume of vessel (V)
exceed 50 bar/L. Such vessels require EC type examination and then CE marking.
15-18-6

SMC Product Conforming to International Standards
national Standards
you to comply with EC directives and CSA/UL standards.
Mark of compliance Mark of compliance
for CSA/UL for CSA
(cid:1) CSA Standards & UL Standards
UL and CSA standards have been applied in North America (U.S.A. and Canada) symbolizing safety of electric
products, and are defined to mainly prevent danger from electric shock or fire, resulting from trouble with
electric products. Both UL and CSA standards are acknowledged in North America as the first class certifying
body. They have a long experience and ability for issuing product safety certificate. Products approved by CSA
or UL standards are accepted in most states and governments beyond question.
Since CSA is a test certifying body as the National Recognized Testing Laboratory (NRTL) within the
jurisdiction of Occupational Safety and Health Administration (OSHA), SMC was tested for compliance with
CSA Standards and UL Standards at the same time and was approved for compliance with the two Standards.
The above CSA NRTL/C logo is described on a product label in order to indicate that the product is approved
by CSA and UL Standards.
(cid:1) TSSA (MCCR) Registration Products
TSSA is the regulation in Ontario State, Canada. The products that the operating pressure is more than 5 psi
(0.03 MPa) and the piping size is bigger than 1 inch. fall into the scope of TSSA regulation.
Products conforming to CE Standard
With CE symbol for simple visual recognition
In this catalog each accredited product series is indicated with a
CE mark symbol. However, in some cases, every available
models may not meet CE compliance. Please visit our web site
for the latest selection of available models with CE mark.
http://www.smcworld.com
15-18-7

SMC’s Global Service Network
America Europe
U.S.A. SMC Corporation of America U.K. SMC Pneumatics (U.K.) Ltd.
3011 North Franklin Road Indianapolis, IN 46226, U.S.A. Vincent Avenue, Crownhill, Milton Keynes, MK8 0AN, Backinghamshire, U.K.
TEL: 317-899-4440 FAX: 317-899-3102 TEL: 01908-563888 FAX: 01908-561185
CANADA SMC Pneumatics (Canada) Ltd. GERMANY SMC Pneumatik GmbH
6768 Financial Drive Mississauga, Ontario, L5N 7J6 Canada Boschring 13-15 D-63329 Egelsbach, Germany
TEL: 905-812-0400 FAX: 905-812-8686 TEL: 06103-4020 FAX: 06103-402139
MEXICO SMC Corporation (Mexico), S.A. DE C.V. ITALY SMC Italia S.p.A.
Carr. Silao-Trejo K.M. 2.5 S/N, Predio San Jose del Duranzo Via Garibaldi 62 I-20061 Carugate Milano, Italy
C.P. 36100, Silao, Gto., Mexico TEL: 02-9271365 FAX: 02-9271365
TEL: 472-72-2-55-00 FAX: 472-72-2-59-44/2-59-46
FRANCE SMC Pneumatique S.A.
CHILE SMC Pneumatics (Chile) S.A. 1 Boulevard de Strasbourg, Parc Gustave Eiffel, Bussy Saint Georges, F-77600
Av. La Montaña 1,115 km. 16,5 P. Norte Parque Marne La Vallee Cedex 3 France
Industrial Valle Grande, Lampa Santiago, Chile TEL: 01-64-76-10-00 FAX: 01-64-76-10-10
TEL: 02-270-8600 FAX: 02-270-8601 SWEDEN SMC Pneumatics Sweden AB
ARGENTINA SMC Argentina S.A. Ekhagsvägen 29-31, S-141 05 Huddinge, Sweden
Teodoro Garcia 3860 (1427) Buenos Aires, Argentina TEL: 08-603-07-00 FAX: 08-603-07-10
TEL: 011-4555-5762 FAX: 011-4555-5762 SWITZERLAND SMC Pneumatik AG
BOLIVIA SMC Pneumatics Bolivia S.R.L. Dorfstrasse 7, Postfach 117, CH-8484 Weisslingen, Switzerland
Avenida Beni Numero 4665 TEL: 052-396-3131 FAX: 052-396-3191
Santa Cruz de la Sierra-Casilla de Correo 2281, Bolivia AUSTRIA SMC Pneumatik GmbH (Austria)
TEL: 591-3-3428383 FAX: 591-3-3449900 Girakstrasse 8, A-2100 Korneuburg, Austria
VENEZUELA SMC Neumatica Venezuela S.A. TEL: 0-2262-6228-0 FAX: 0-2262-62285
Apartado 40152, Avenida Nueva Granada, Edificio Wanlac, SPAIN SMC España, S.A.
Local 5, Caracas 1040-A, Venezuela Zuazobidea 14 Pol. Ind. Júndiz 01015 Vitoria, Spain
TEL: 2-632-1310 FAX: 2-632-3871 TEL: 945-184-100 FAX: 945-184-510
PERU (Distributor) IMPECO Automatizacion Industrial S.A.
IRELAND SMC Pneumatics (Ireland) Ltd.
AV. Canevaro 752, Lince, Lima, Peru
2002 Citywest Business Campus, Naas Road, Saggart, Co. Dublin, Ireland
TEL: 1-471-6002 FAX: 1-471-0935
TEL: 01-403-9000 FAX: 01-466-0385
URUGUAY (Distributor) BAKO S.A.
NETHERLANDS (Associated company) SMC Pneumatics BV
Galicia 1650 esq. Gaboto C.P. 11200, Montevideo, Uruguay
De Ruyterkade 120, NL-1011 AB Amsterdam, Netherlands
TEL: 2-401-6603 FAX: 2-409-4306
TEL: 020-5318888 FAX: 020-5318880
BRAZIL SMC Pneumaticos Do Brasil Ltda. GREECE (Distributor) S.Parianopoulos S.A.
Rua. Dra. Maria Fidelis, nr. 130, Jardim Piraporinha-Diadema-S.P. 7, Konstantinoupoleos Street 11855 Athens, Greece
CEP: 09950-350, Brasil TEL: 01-3426076 FAX: 01-3455578
TEL: 11-4051-1177 FAX: 11-4071-6636
DENMARK SMC Pneumatik A/S
COLOMBIA (Distributor) Airmatic Ltda. Knudsminde 4 B DK-8300
Calle 18 69-05 Apart. Aereo 081045 Santa Fe de Bogotá, Colombia Odder, Denmark
TEL: 1-424-9240 FAX: 1-424-9260 TEL: 70252900 FAX: 70252901
15-18-20

SMC’s Global Service Network
Europe Oceania/Asia
FINLAND SMC Pneumatics Finland OY AUSTRALIA SMC Pneumatics (Australia) Pty.Ltd.
PL72, Tiistinniityntie 4, SF-02231 ESP00, Finland 14-18 Hudson Avenue Castle Hill NSW 2154, Australia
TEL: 09-8595-80 FAX: 09-8595-8595 TEL: 02-9354-8222 FAX: 02-9894-5719
NORWAY SMC Pneumatics Norway A/S NEW ZEALAND SMC Pneumatics (New Zealand) Ltd.
Vollsveien 13C, Granfoss Næringspark N-1366 LYSAKER, Norway 8C Sylvia Park Road Mt.Wellington Auckland, New Zealand
TEL: 67-12-90-20 FAX: 67-12-90-21 TEL: 09-573-7007 FAX: 09-573-7002
BELGIUM (Distributor) SMC Pneumatics N.V./S.A. TAIWAN SMC Pneumatics (Taiwan) Co.,Ltd.
Nijverheidsstraat 20 B-2160 Wommelgem Belguim 17, Lane 205, Nansan Rd., Sec.2, Luzhu-Hsiang, Taoyuan-Hsien, TAIWAN
TEL: 03-355-1464 FAX: 03-355-1466 TEL: 03-322-3443 FAX: 03-322-3387
POLAND SMC Industrial Automation Polska Sp.z.o.o. HONG KONG SMC Pneumatics (Hong Kong) Ltd.
ul. Konstruktorska 11A, PL-02-673 Warszawa, Poland 29/F, Clifford Centre, 778-784 Cheung, Sha Wan Road, Lai Chi Kok, Kowloon,
TEL: 022-548-5085 FAX: 022-548-5087 Hong Kong
TEL: 2744-0121 FAX: 2785-1314
TURKEY (Distributor) Entek Pnömatik San.ve Tic. Ltd. Sti
Perpa Tic. Merkezi Kat:11 No.1625 80270 Okmeydani Istanbul, Türkiye SINGAPORE SMC Pneumatics (S.E.A.) Pte. Ltd.
TEL: 0212-221-1512 FAX: 0212-221-1519 89 Tuas Avenue 1, Jurong Singapore 639520
TEL: 6861-0888 FAX: 6861-1889
RUSSIA SMC Pneumatik LLC.
36/40 Sredny prospect V.O. St. Petersburg 199004, Russia PHILIPPINES SHOKETSU SMC Corporation
TEL: 812-118-5445 FAX: 812-118-5449 Unit 201 Common Goal Tower, Madrigal Business Park,
Ayala Alabang Muntinlupa, Philippines
CZECH SMC Industrial Automation CZ s.r.o.
TEL: 02-8090565 FAX: 02-8090586
Hudcova 78a, CZ-61200 Brno, Czech Republic
TEL: 05-4121-8034 FAX: 05-4121-8034 MALAYSIA SMC Pneumatics (S.E.A.) Sdn. Bhd.
HUNGARY SMC Hungary Ipari Automatizálási kft. Lot 36 Jalan Delima1/1, Subang Hi-Tech Industrial Park, Batu 3 40000 Shah Alam
Budafoki ut 107-113 1117 Budapest Selangor, Malaysia
TEL: 01-371-1343 FAX: 01-371-1344 TEL: 03-56350590 FAX: 03-56350602
ROMANIA SMC Romania S.r.l. SOUTH KOREA SMC Pneumatics Korea Co., Ltd.
Str. Frunzei, Nr. 29, Sector 2, Bucharest, Romania Woolim e-BIZ Center (Room 1008), 170-5, Guro-Dong, Guro-Gu,
TEL: 01-3205111 FAX: 01-3261489 Seoul, 152-050, South Korea
TEL: 02-3219-0700 FAX: 02-3219-0702
SLOVAKIA SMC Priemyselná automatizáciá, s.r.o
Nova 3, SK-83103 Bratislava CHINA SMC (China) Co., Ltd.
TEL: 02-4445-6725 FAX: 02-4445-6028 7 Wan Yuan St. Beijing Economic & Technological Development Zone 100176, China
TEL: 010-67882111 FAX: 010-67881837
SLOVENIA SMC Industrijska Avtomatilca d.o.o.
Grajski trg 15, SLO- 8360 Zuzemberk, Slovenia THAILAND SMC Thailand Ltd.
TEL: 07388-5240 FAX: 07388-5249 134/6 Moo 5, Tiwanon Road, Bangkadi, Amphur Muang, Patumthani 12000, Thailand
TEL: 02-963-7099 FAX: 02-501-2937
INDIA SMC Pneumatics (India) Pvt. Ltd.
D-107 to 112, Phase-2, Extension, Noida, Dist. Gautaim Budh Nagar,
U.P. 201 305, India
TEL: (0120)-4568730 FAX: 0120-4568933
SOUTH AFRICA (Distributor) Hyflo Southern Africa (Pty.) Ltd.
P.O.Box 240 Paardeneiland 7420 South Africa INDONESIA (Distributor) P.T. Riyadi Putera Makmur
TEL: 021-511-7021 FAX: 021-511-4456 Jalan Hayam Wuruk Komplek Glodok Jaya No. 27-28 Jakarta 11180 Indonesia
TEL: 021-625 5548 FAX: 021-625 5888
EGYPT (Distributor) Saadani Trading & Ind. Services
15 Sebaai Street, Miami 21411 Alexandria, Egypt PAKISTAN (Distributor) Jubilee Corporation
TEL: 3-548-50-34 FAX: 3-548-50-34 First Floor Mercantile Centre, Newton Road Near Boulton Market P.O. Box 6165
Karachi 74000 Pakistan
TEL: 021-243-9070/8449 FAX: 021-241-4589
ISRAEL (Distributor) Baccara Automation Control
Kvutzat Geva 18915 Israel
TEL: 04-653-5960 FAX: 04-653-1445
SAUDI ARABIA (Distributor) Assaggaff Trading Est.
P.O. Box 3385 Al-Amir Majed Street, Jeddah-21471, Saudi Arabia
TEL: 02-6761574 FAX: 02-6708173
15-18-21
