pajagua/recolector-de-frutas/docs/protocolo.md

# Protocolo serial PC <-> MEGA

Pendiente de definir. Una línea de texto por comando, terminada en `\n`.

Comandos previstos: `HOME`, `MOVE <eje> <valor>`, `SUCTION <0|1>`, `STOP`, `STATUS`.
