pajagua/recolector-de-frutas/cad/solidworks/06_Imagenes/CB-000_mecanismo_trimetric.png

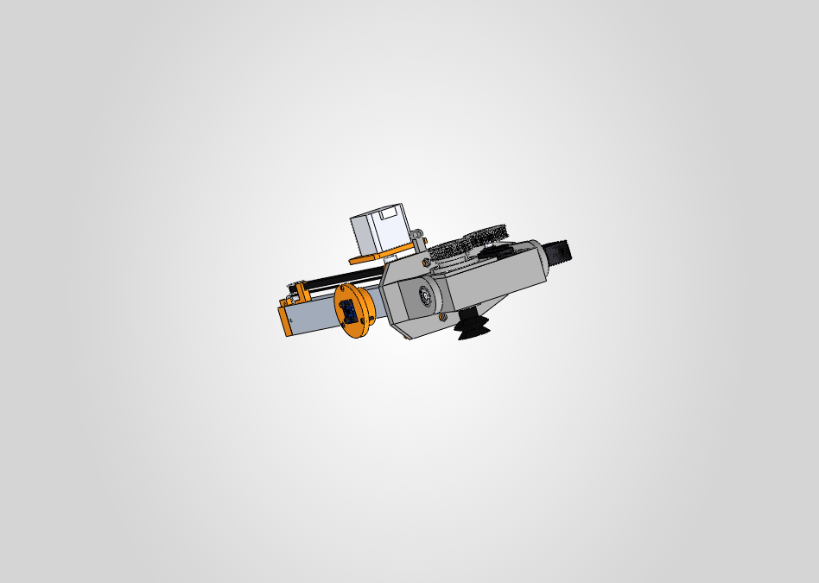
cad/solidworks/06_Imagenes/CB-000_mecanismo_trimetric.png
