pajagua/recolector-de-frutas/cad/solidworks/06_Imagenes/CB-000A_iso.png

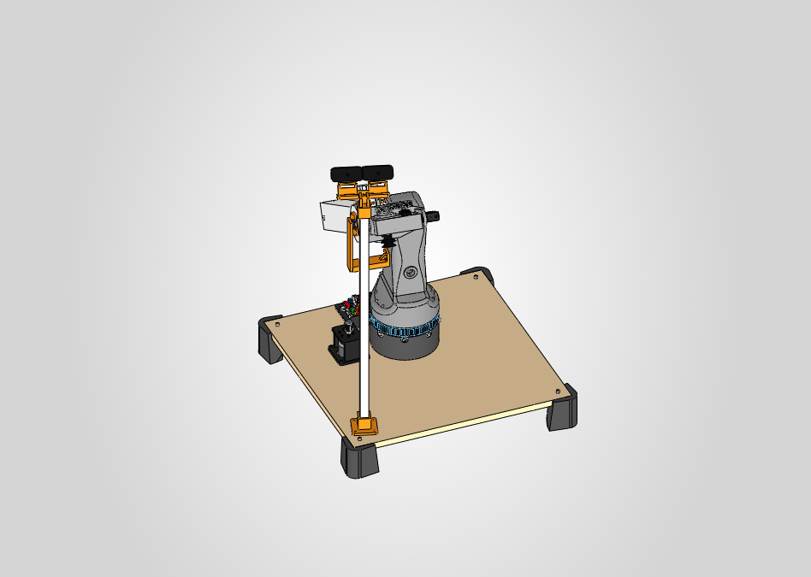
cad/solidworks/06_Imagenes/CB-000A_iso.png
