pajagua/recolector-de-frutas/cad/solidworks/06_Imagenes/CB-000A_right.png

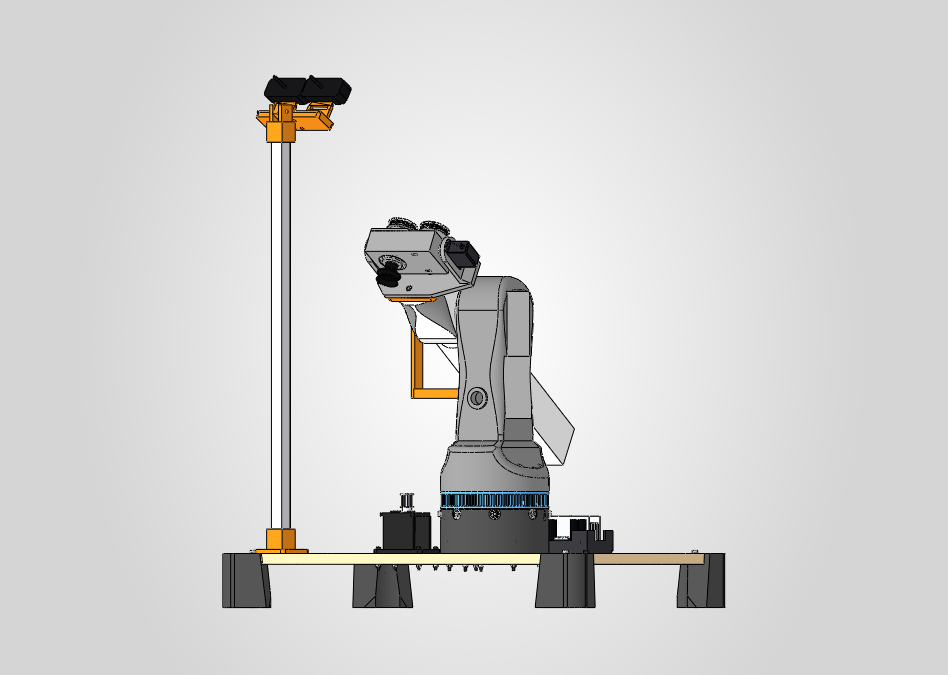
cad/solidworks/06_Imagenes/CB-000A_right.png
