pajagua/recolector-de-frutas/cad/solidworks/06_Imagenes/CB-001_Brazo_Solo_trimetric.png

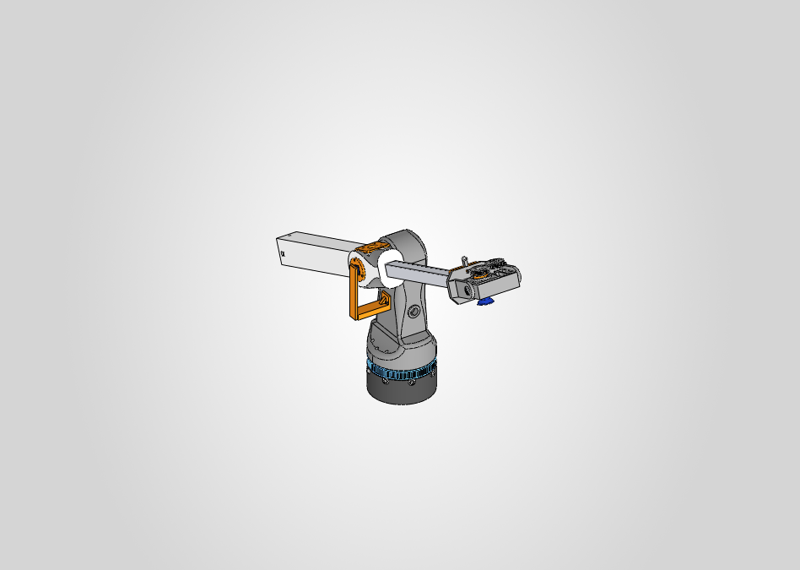
cad/solidworks/06_Imagenes/CB-001_Brazo_Solo_trimetric.png
