pajagua/recolector-de-frutas/cad/solidworks/06_Imagenes/CB-130_Modulo_Motor_J1_trimetric.png

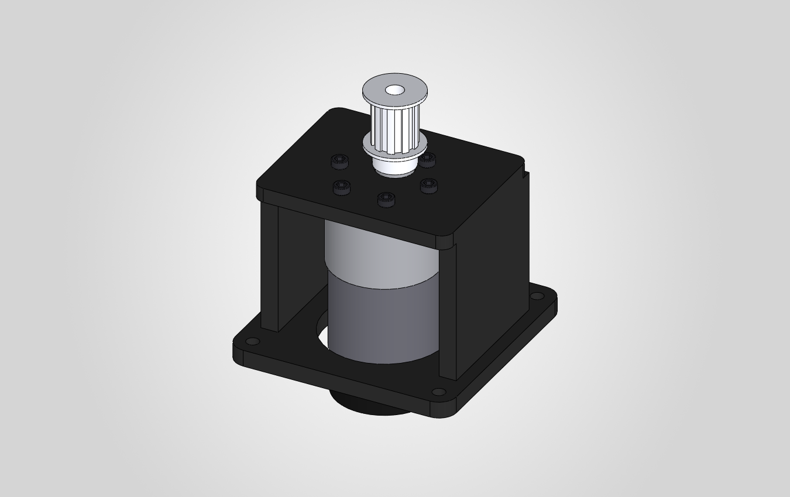
cad/solidworks/06_Imagenes/CB-130_Modulo_Motor_J1_trimetric.png
