pajagua/recolector-de-frutas/cad/solidworks/06_Imagenes/CB-140_Modulo_Electronica_trimetric.png

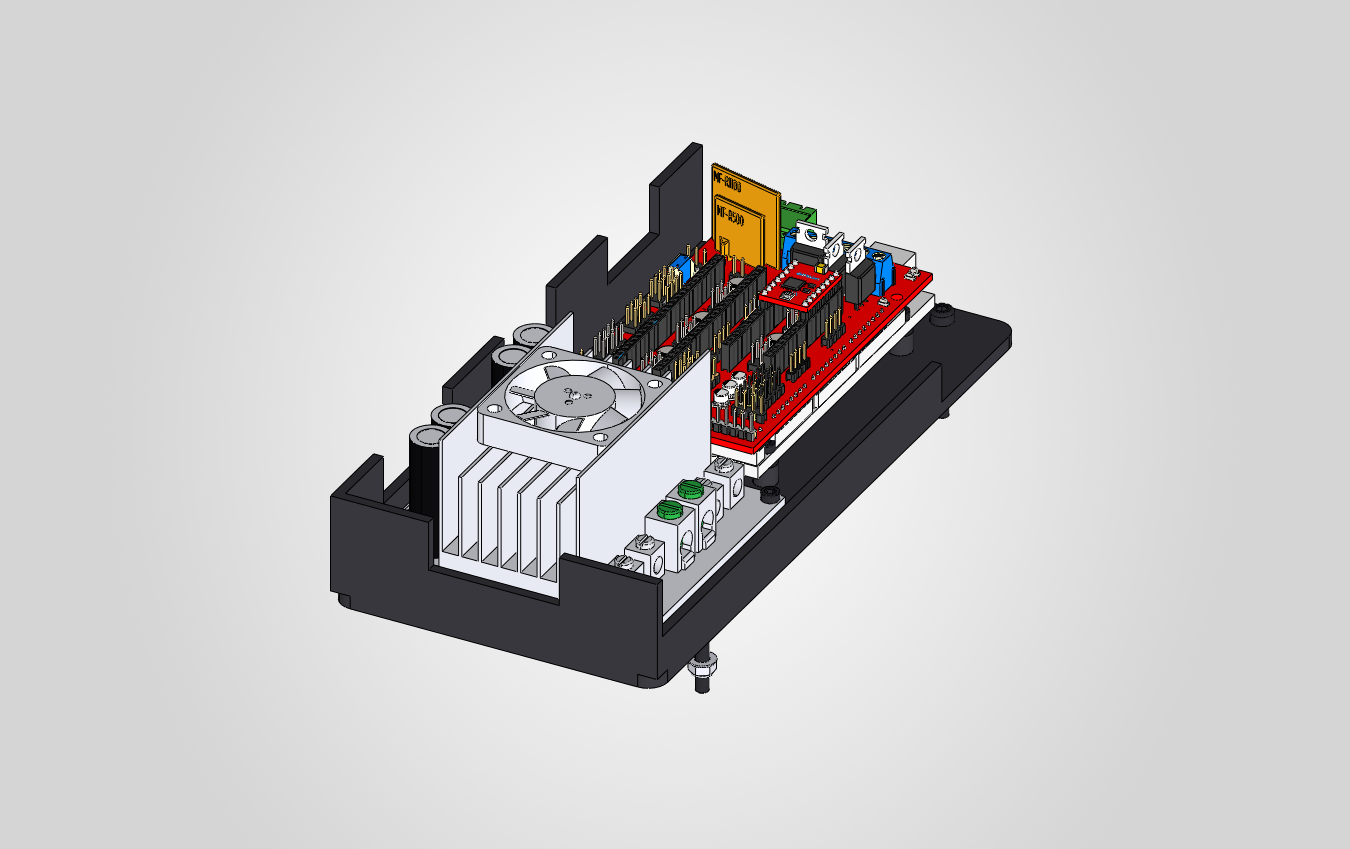
cad/solidworks/06_Imagenes/CB-140_Modulo_Electronica_trimetric.png
