pajagua/recolector-de-frutas/cad/solidworks/06_Imagenes/CB-150_Modulo_Camaras_front.png

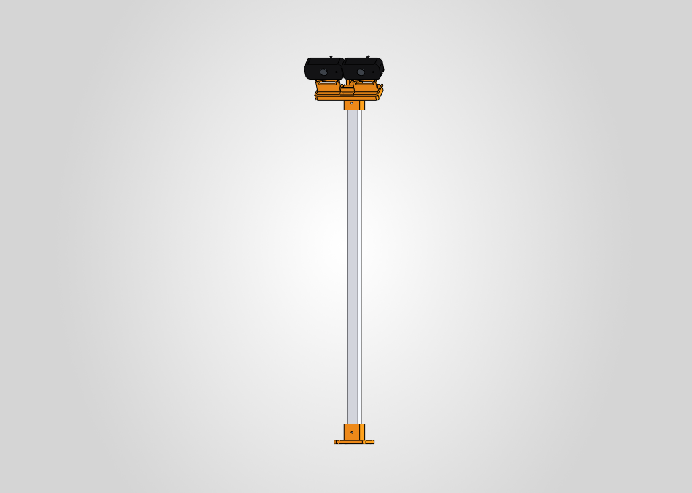
cad/solidworks/06_Imagenes/CB-150_Modulo_Camaras_front.png
