pajagua/recolector-de-frutas/cad/solidworks/06_Imagenes/CB-150_Soporte_Estereo_explosion.png

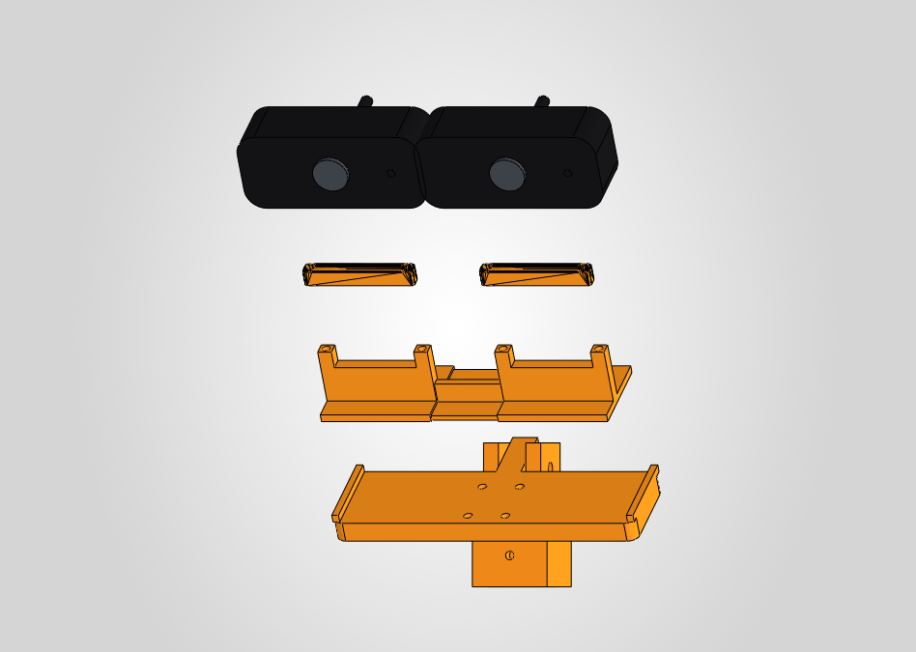
cad/solidworks/06_Imagenes/CB-150_Soporte_Estereo_explosion.png
