pajagua/recolector-de-frutas/cad/solidworks/06_Imagenes/CB-158_Adaptador_Rotula_Bola12_trimetric.png

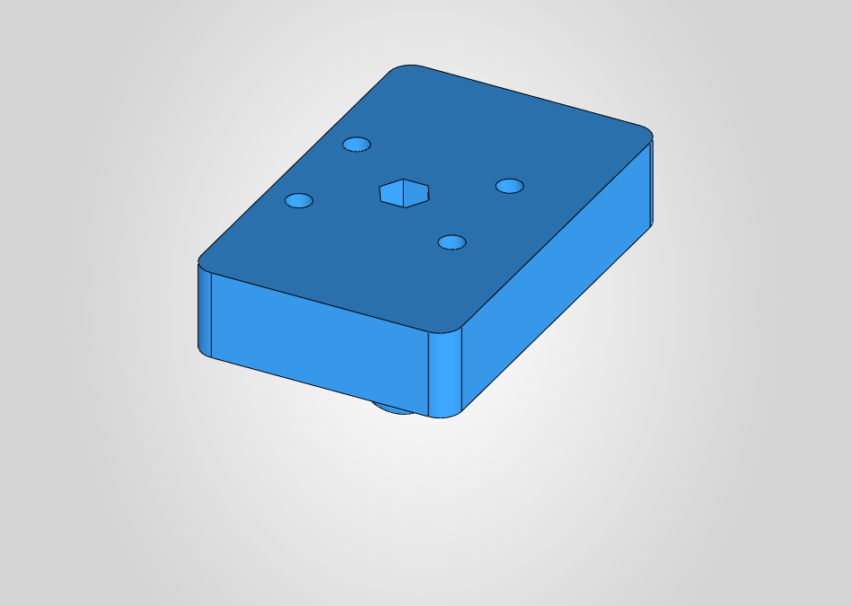
cad/solidworks/06_Imagenes/CB-158_Adaptador_Rotula_Bola12_trimetric.png
