pajagua/recolector-de-frutas/cad/solidworks/06_Imagenes/CB-200_Cintura_J1_trimetric.png

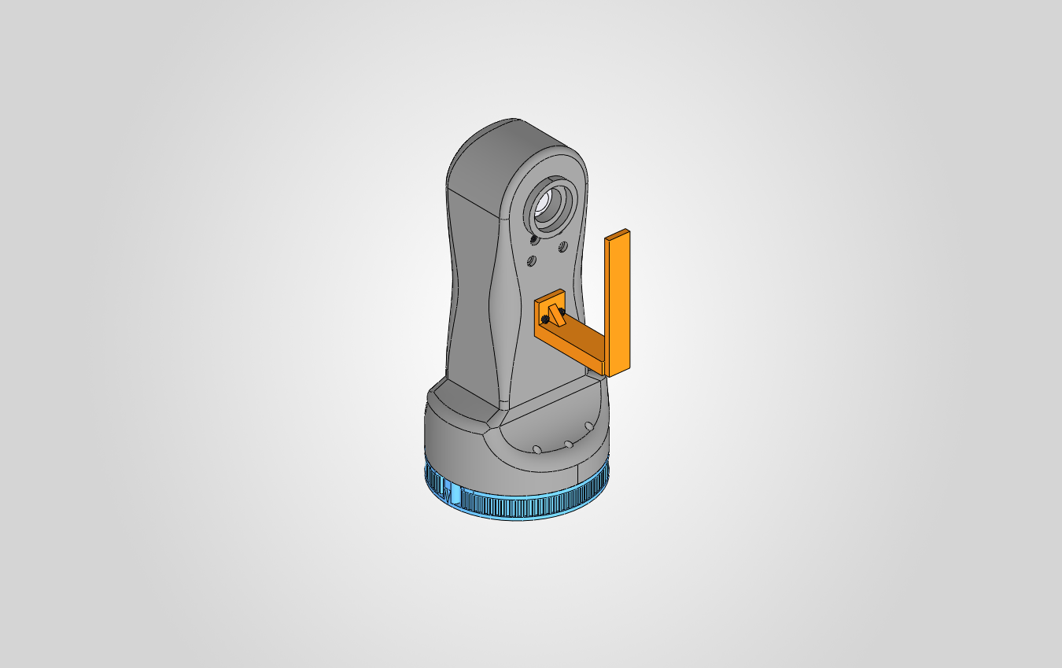
cad/solidworks/06_Imagenes/CB-200_Cintura_J1_trimetric.png
