pajagua/recolector-de-frutas/cad/solidworks/06_Imagenes/CB-303_Tapa_E2_Soporte_AS5600_trimetric.png

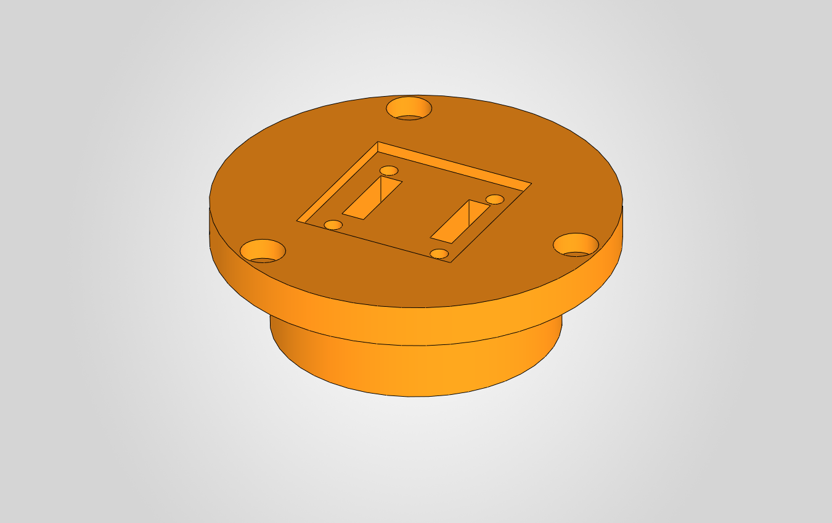
cad/solidworks/06_Imagenes/CB-303_Tapa_E2_Soporte_AS5600_trimetric.png
