pajagua/recolector-de-frutas/cad/solidworks/06_Imagenes/CB-600_Herramienta_Ventosa_corte_front.png

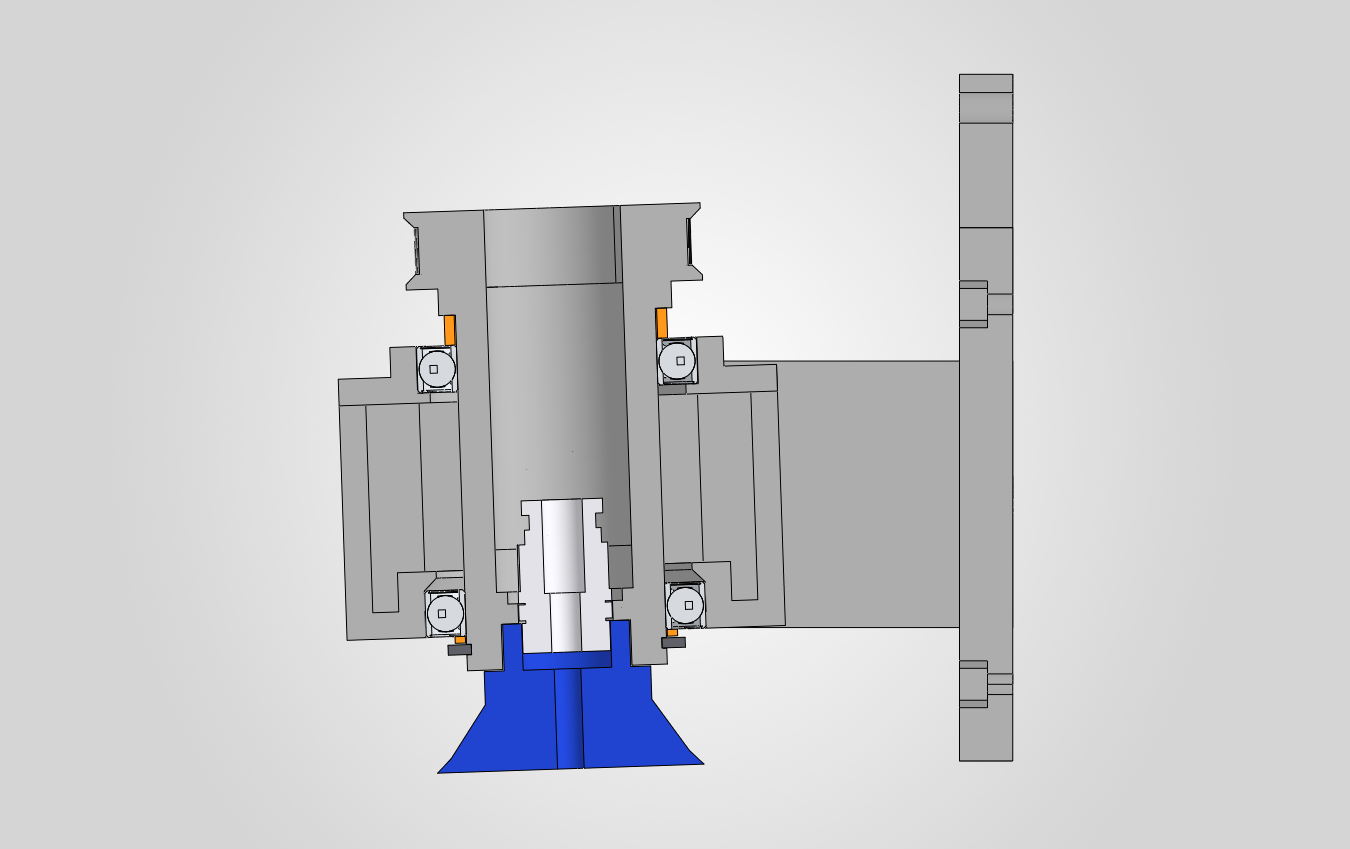
cad/solidworks/06_Imagenes/CB-600_Herramienta_Ventosa_corte_front.png
