pajagua/recolector-de-frutas/cad/solidworks/06_Imagenes/CB-602_Porta_Servo_trimetric.png

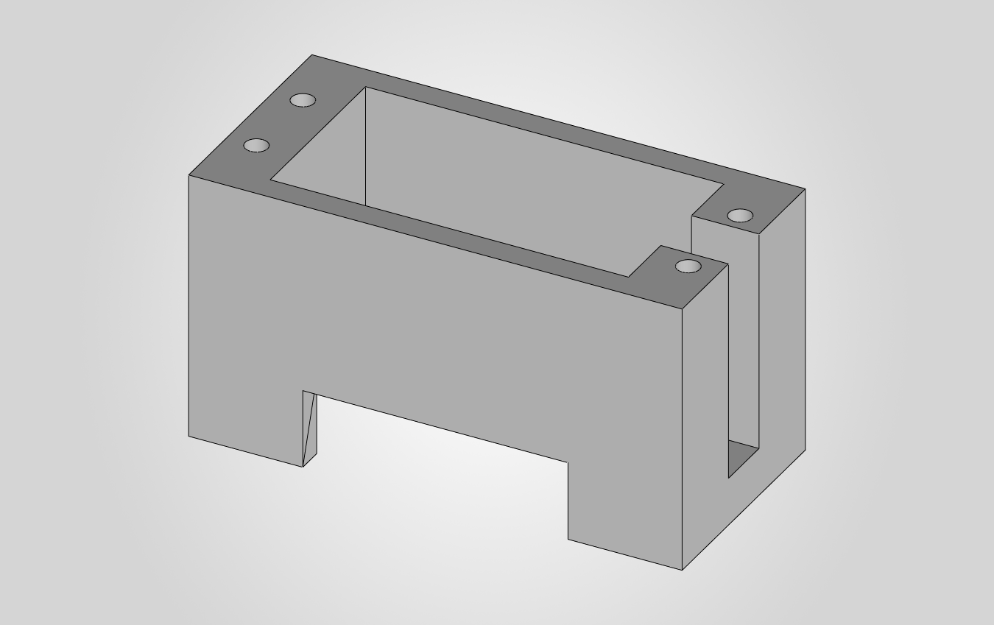
cad/solidworks/06_Imagenes/CB-602_Porta_Servo_trimetric.png
