pajagua/recolector-de-frutas/docs/imagenes/DiagrFlujR1.drawio.png

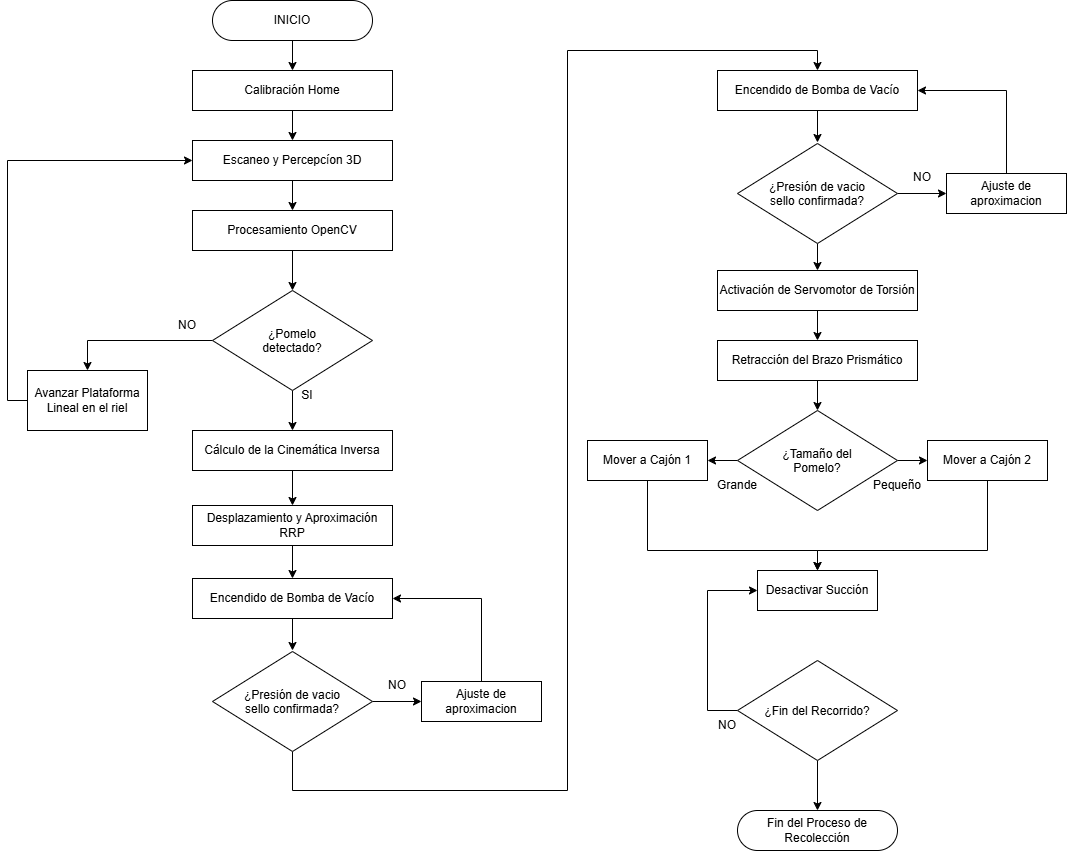
docs/imagenes/DiagrFlujR1.drawio.png
