pajagua/recolector-de-frutas/docs/imagenes/DiagrFlujR1_22.drawio.png

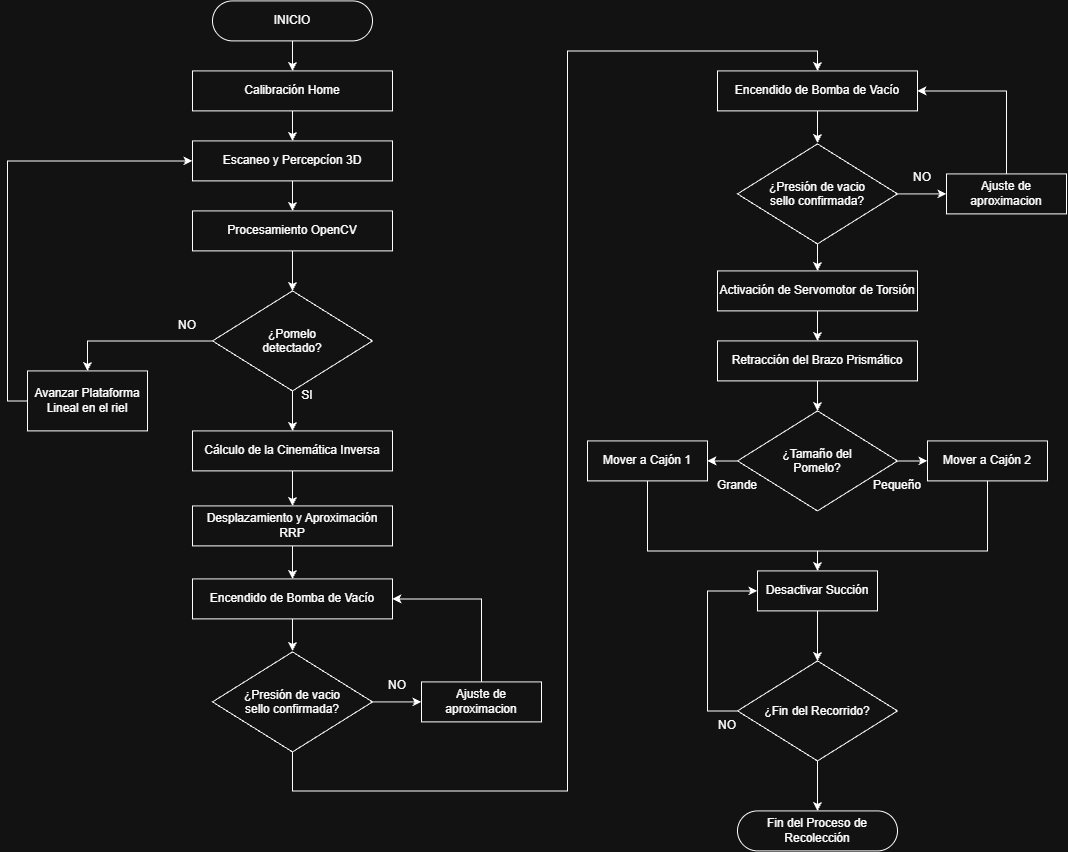
docs/imagenes/DiagrFlujR1_22.drawio.png
