pajagua/recolector-de-frutas/docs/imagenes/Proto.png

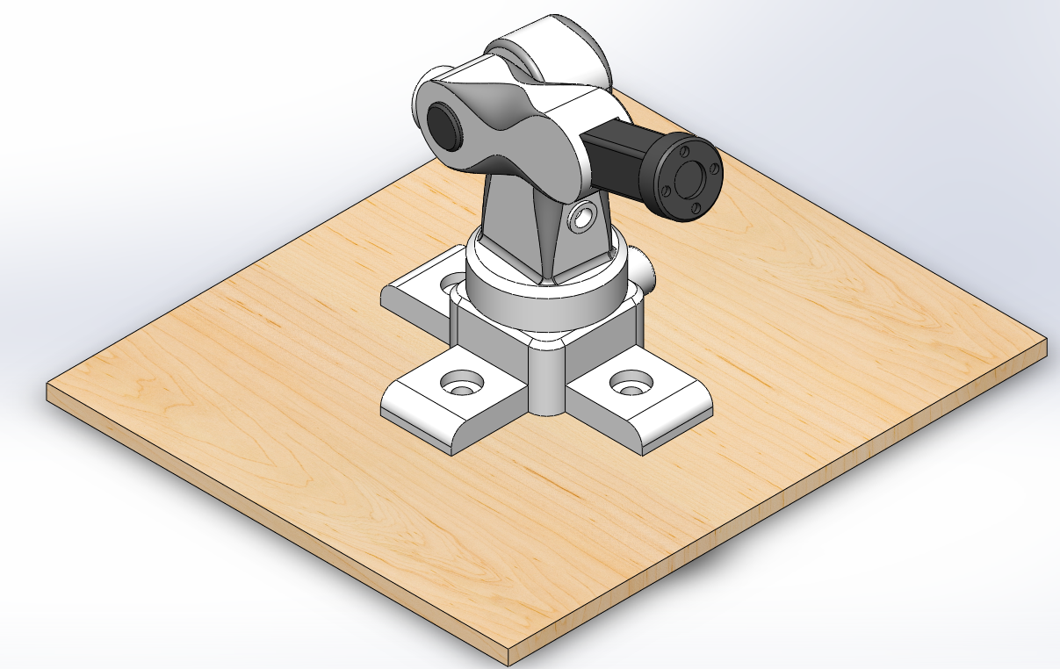
docs/imagenes/Proto.png
