pajagua/recolector-de-frutas/entregas/entrega_06/Firmware_Control/codigo_pid/Control de Posicion.png

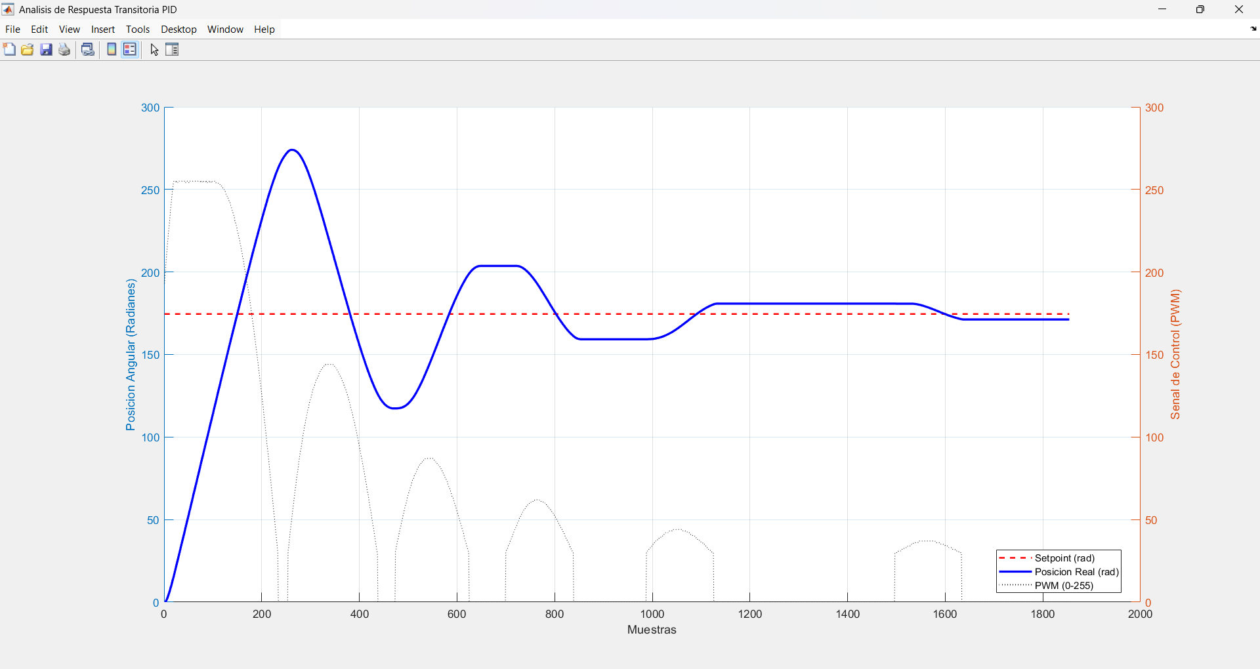
entregas/entrega_06/Firmware_Control/codigo_pid/Control de Posicion.png
