pajagua/recolector-de-frutas/entregas/entrega_06/Firmware_Control/codigo_pid_velocidad/Control de Velocidad.png

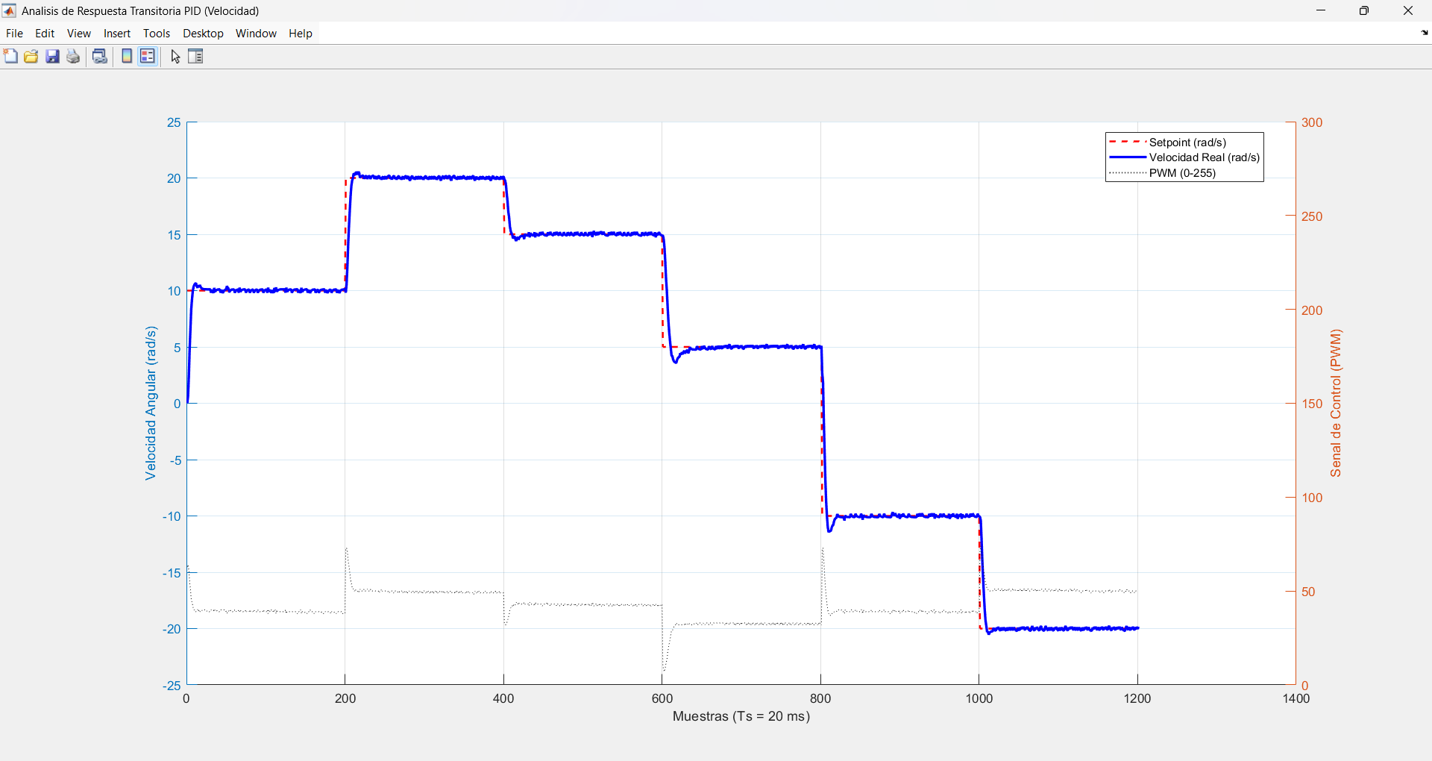
entregas/entrega_06/Firmware_Control/codigo_pid_velocidad/Control de Velocidad.png
