pajagua/recolector-de-frutas/entregas/entrega_06/isometricoHerramienta.png

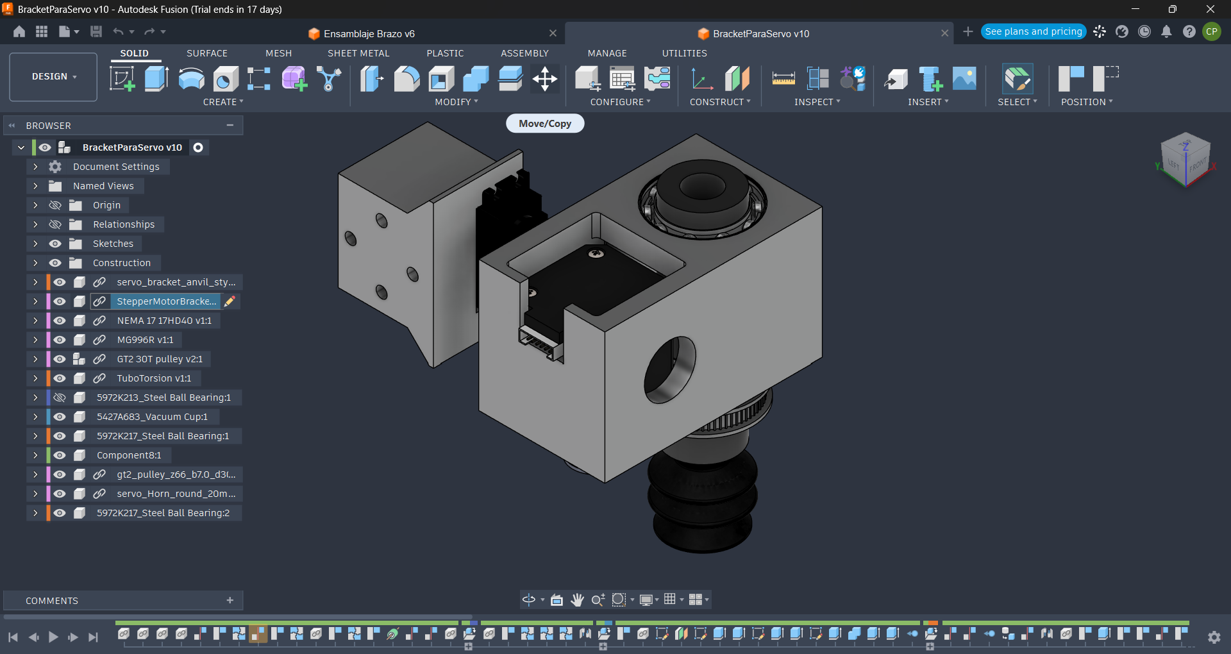
entregas/entrega_06/isometricoHerramienta.png
