pajagua/recolector-de-frutas/entregas/entrega_06/Vista1.png

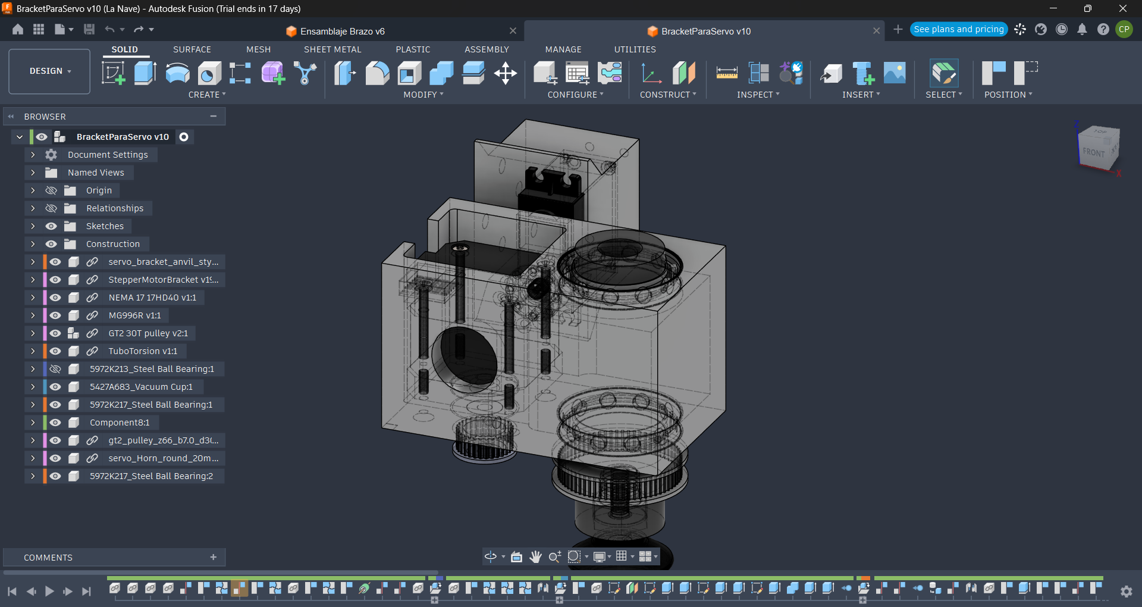
entregas/entrega_06/Vista1.png
