pajagua/recolector-de-frutas/cad/herramienta/Sketch1.dxf

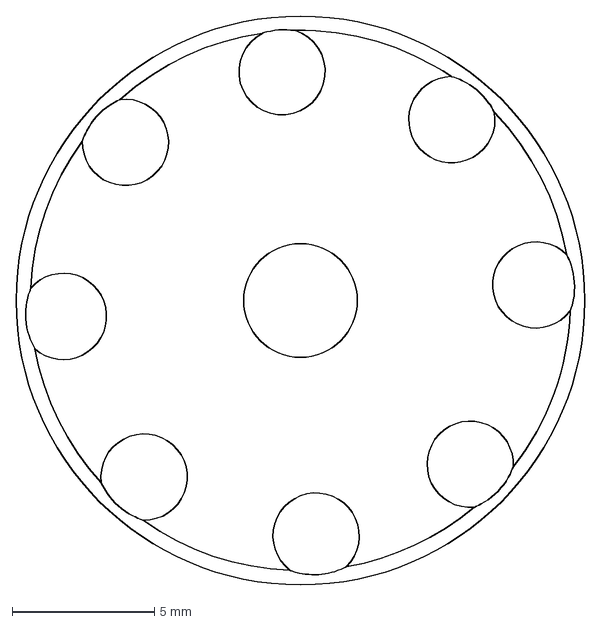
[picture p41: CAD file, 2026-10-21]
cad/herramienta/Sketch1.dxf
20.0 x 20.0 mm
