pajagua/recolector-de-frutas/cad/solidworks/04_Prismatico_E3_J3/Sketch1.dxf

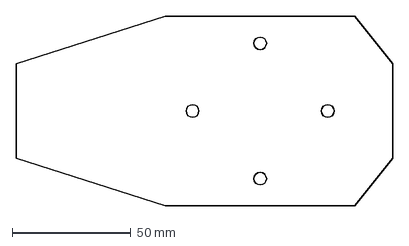
[picture p42: CAD file, 2026-10-21]
cad/solidworks/04_Prismatico_E3_J3/Sketch1.dxf
158.9 x 80.0 mm
