pajagua/recolector-de-frutas/(list of files, cad)

Other CAD files:
cad/solidworks/01_Base_J0/CB-110_Base_Tablero_Patas.SLDASM
cad/solidworks/02_Cintura_J1/CB-200_Cintura_J1.SLDASM
cad/solidworks/03_Hombro_E2_J2/CB-300_Hombro_E2_J2.SLDASM
cad/solidworks/04_Prismatico_E3_J3/CB-400_Prismatico_E3_J3.SLDASM
cad/solidworks/07_STEP/CB-000_CitriBot_Ensamblaje_General.step
cad/solidworks/11_v7B_Prismatico_Telescopico/CB-300B_Hombro_E2_v7B.SLDASM
cad/solidworks/13_Brazo_Solo/CB-400BS_Prismatico_E3_v7B.SLDASM
cad/solidworks/CB-000A_CitriBot_v7A_Correa.SLDASM
cad/solidworks/01_Base_J0/CB-140_Modulo_Electronica.SLDASM
cad/solidworks/11_v7B_Prismatico_Telescopico/CB-410B_Tramo_Intermedio_v7B.SLDASM
cad/solidworks/13_Brazo_Solo/CB-200S_Cintura_J1_Sin_Motor.SLDASM
cad/solidworks/CB-000_CitriBot_Ensamblaje_General.SLDASM
cad/solidworks/01_Base_J0/CB-120_LazySusan_Fija_J1.SLDASM
cad/solidworks/13_Brazo_Solo/CB-600S_Herramienta_Sin_Servos.SLDASM
cad/solidworks/01_Base_J0/CB-160_Finales_Carrera_Base.SLDASM
cad/solidworks/09_Herramienta/CB-600_Herramienta.SLDASM
cad/solidworks/11_v7B_Prismatico_Telescopico/CB-450B_Prismatico_Telescopico_Solo.SLDASM
cad/solidworks/13_Brazo_Solo/CB-100S_Base_Brazo.SLDASM
cad/solidworks/01_Base_J0/CB-100_Base_J0.SLDASM
cad/solidworks/12_Pruebas/CB-159_Camaras_Prueba_Tripode.SLDASM
cad/solidworks/13_Brazo_Solo/CB-001_Brazo_Solo.SLDASM
cad/solidworks/11_v7B_Prismatico_Telescopico/CB-420B_Tramo_Interior_v7B.SLDASM
cad/solidworks/13_Brazo_Solo/CB-300BS_Hombro_E2_v7B_Sin_Motor.SLDASM
cad/solidworks/11_v7B_Prismatico_Telescopico/CB-400B_Prismatico_E3_v7B.SLDASM
cad/solidworks/01_Base_J0/CB-150_Modulo_Camaras.SLDASM
cad/solidworks/01_Base_J0/CB-122_Rodillo_LazySusan.SLDASM
cad/solidworks/09_Herramienta/CB-611_Servo_MG996R_Torsion.SLDASM
cad/solidworks/09_Herramienta/CB-610_Servo_MG996R_Muneca.SLDASM
cad/solidworks/01_Base_J0/CB-130_Modulo_Motor_J1.SLDASM
cad/solidworks/09_Herramienta/Ensamblaje.step
cad/herramienta/stl/AnilloDeRetencion.stl
cad/imprimir/00_Herramienta/CB-602_Porta_Servo.3mf
cad/imprimir/01_Base_J0/CB-162_Soporte_Final_Carrera_J0.stl
cad/imprimir/02_Cintura_J1/CB-210_Torre_Cintura_2M1D_mod.stl
cad/imprimir/03_Hombro_E2_J2/CB-307_Soporte_Final_Carrera_J3.stl
cad/imprimir/04_Prismatico_E3_J3/CB-403_Tapon_Trasero_Pinza_Correa.stl
cad/imprimir/11_v7B_Prismatico_Telescopico/CB-422B_Buje_Trasero_Interior_Pinza_2a1.stl
cad/imprimir/12_Pruebas/CB-211_Prueba_Montaje_5840.stl
cad/solidworks/05_Comerciales/CB-502_Motor_Sinfin_5840-36ZY.SLDPRT
cad/solidworks/05_Comerciales/Electronica/CB-508_RAMPS_1.4.SLDPRT
cad/solidworks/05_Comerciales/Tornilleria/HW_M2.5x8.SLDPRT
cad/solidworks/09_Herramienta/CB-607_Separador.SLDPRT
cad/solidworks/12_Pruebas/CB-211_Prueba_Montaje_5840.SLDPRT
entregas/entrega_06/CAD/soporte_U_muneca.stl
entregas/entrega_07/EngranajeSol.stl
entregas/entrega_07/para_imprimir/BaseSimple.3mf
simulink/brazo_telescopico/CB-301B_Eslabon_E2_v7B_Telescopico_Predeterminado_sldprt.STEP
cad/herramienta/stl/Caja.stl
cad/imprimir/00_Herramienta/CB-622_Arandela_Seguro_Eje.stl
cad/imprimir/01_Base_J0/CB-142_Soporte_PCA9685.stl
cad/imprimir/02_Cintura_J1/CB-201_Plato_Giratorio_Polea_J1_1M1B.stl
cad/imprimir/03_Hombro_E2_J2/CB-301_Eslabon_E2_mod5840.stl
cad/imprimir/04_Prismatico_E3_J3/CB-402_Brida_E3_Herramienta.stl
cad/imprimir/11_v7B_Prismatico_Telescopico/CB-415B_Pinza_Correa_Etapa1.stl
cad/imprimir/12_Pruebas/CB-158_Adaptador_Rotula_Bola12.stl
cad/solidworks/02_Cintura_J1/CB-210_Torre_Cintura_2M1D_mod.SLDPRT
cad/solidworks/03_Hombro_E2_J2/CB-301_Eslabon_E2_mod5840.SLDPRT
cad/solidworks/04_Prismatico_E3_J3/CB-401_Tubo_E3_Aluminio_30x30x2.SLDPRT
cad/solidworks/05_Comerciales/Electronica/CB-516_Microswitch_Palanca_19.8x6.4.SLDPRT
cad/solidworks/05_Comerciales/HW_Rodamiento_608ZZ_8x22x7.SLDPRT
cad/solidworks/05_Comerciales/Tornilleria/HW_M3x6_Allen_DIN912.SLDPRT
cad/solidworks/07_STEP/2M1D_original_usuario.STEP
cad/solidworks/09_Herramienta/CB-616_Rodamiento_5972K91.SLDPRT
cad/solidworks/12_Pruebas/Body2.SLDPRT
entregas/entrega_07/Axe_Sortie_Reforzado.stl
entregas/entrega_07/para_imprimir/Base.3mf
simulink/brazo_telescopico/HW_Separador_M5x10_Predeterminado_sldprt.STEP
cad/herramienta/stl/HorquillaU.stl
cad/imprimir/00_Herramienta/CB-601_Horquilla_U.stl
cad/imprimir/01_Base_J0/CB-121_Placa_Fija_J1_1M2A.stl
cad/imprimir/02_Cintura_J1/CB-232_Soporte_Iman_J2.stl
cad/imprimir/03_Hombro_E2_J2/CB-303_Tapa_E2_Soporte_AS5600.stl
cad/imprimir/11_v7B_Prismatico_Telescopico/CB-414B_Buje_Delantero_Intermedio.stl
cad/solidworks/02_Cintura_J1/CB-201_Plato_Giratorio_Polea_J1_1M1B.SLDPRT
cad/solidworks/03_Hombro_E2_J2/CB-305_Buje_D8_Hombro.SLDPRT
cad/solidworks/04_Prismatico_E3_J3/CB-402_Brida_E3_Herramienta.SLDPRT
cad/solidworks/05_Comerciales/Electronica/CB-509_Driver_A4988.SLDPRT
cad/solidworks/05_Comerciales/HW_Polea_GT2_20T_D5.SLDPRT
cad/solidworks/05_Comerciales/Tornilleria/HW_M5x30.SLDPRT
cad/solidworks/09_Herramienta/CB-615_Rodamiento_5972K217.SLDPRT
cad/solidworks/11_v7B_Prismatico_Telescopico/CB-421B_Tubo_Interior_20x20x1.5_L263.SLDPRT
cad/solidworks/12_Pruebas/Body1.SLDPRT
entregas/entrega_07/Base.stl
entregas/entrega_07/para_imprimir/AxeSortie.3mf
simulink/brazo_telescopico/HW_M4x45_Predeterminado_sldprt.STEP
cad/herramienta/stl/Tapa.stl
cad/imprimir/00_Herramienta/CB-620_Llave_Montaje_Racor.stl
cad/imprimir/01_Base_J0/CB-161_Soporte_Final_Carrera_J1.stl
cad/imprimir/03_Hombro_E2_J2/CB-305_Buje_D8_Hombro.stl
cad/imprimir/11_v7B_Prismatico_Telescopico/CB-412B_Tapon_Trasero_Intermedio_Polea.stl
cad/solidworks/02_Cintura_J1/CB-232_Soporte_Iman_J2.SLDPRT
cad/solidworks/03_Hombro_E2_J2/CB-307_Soporte_Final_Carrera_J3.SLDPRT
cad/solidworks/04_Prismatico_E3_J3/CB-403_Tapon_Trasero_Pinza_Correa.SLDPRT
cad/solidworks/05_Comerciales/CB-506_Eje_Salida_5840_D8.SLDPRT
cad/solidworks/05_Comerciales/Electronica/CB-517_Modulo_PCA9685.SLDPRT
cad/solidworks/05_Comerciales/Tornilleria/HW_Tuerca_M4_Autoblocante.SLDPRT
cad/solidworks/12_Pruebas/CB-158_Adaptador_Rotula_Bola12.SLDPRT
entregas/entrega_07/Brazo3Ejes_GA25.stl
entregas/entrega_07/para_imprimir/EngranajeSol.3mf
simulink/brazo_telescopico/CB-201_Plato_Giratorio_Polea_J1_1M1B_Predeterminado_sldprt.STEP
cad/herramienta/stl/PortaServo.stl
cad/imprimir/00_Herramienta/CB-606_Eje_Hueco_Polea.stl
cad/imprimir/01_Base_J0/CB-131_Soporte_Motor_J1_37D.stl
cad/imprimir/03_Hombro_E2_J2/CB-306_Placa_Soporte_NEMA17_Prismatico.stl
cad/imprimir/11_v7B_Prismatico_Telescopico/CB-432B_Brida_E3_Herramienta_20x20.stl
cad/solidworks/03_Hombro_E2_J2/CB-303_Tapa_E2_Soporte_AS5600.SLDPRT
cad/solidworks/05_Comerciales/Electronica/CB-507_Arduino_Mega_2560.SLDPRT
cad/solidworks/05_Comerciales/HW_Polea_Loca_GT2_20T_D5.SLDPRT
cad/solidworks/05_Comerciales/Tornilleria/HW_Tuerca_M5_Autoblocante.SLDPRT
cad/solidworks/09_Herramienta/CB-601_Horquilla_U.SLDPRT
cad/solidworks/11_v7B_Prismatico_Telescopico/CB-301B_Eslabon_E2_v7B_Telescopico.SLDPRT
entregas/entrega_07/para_imprimir/Eslabon.3mf
entregas/entrega_07/Prueba.stl
simulink/brazo_telescopico/HW_M4x30_Predeterminado_sldprt.STEP
cad/herramienta/stl/PoleaServo.stl
cad/imprimir/00_Herramienta/CB-621_Separador_Eje_Hueco.stl
cad/imprimir/01_Base_J0/CB-112_Pata_Base.stl
cad/imprimir/11_v7B_Prismatico_Telescopico/CB-301B_Eslabon_E2_v7B_Telescopico.stl
cad/solidworks/01_Base_J0/CB-162_Soporte_Final_Carrera_J0.SLDPRT
cad/solidworks/03_Hombro_E2_J2/CB-306_Placa_Soporte_NEMA17_Prismatico.SLDPRT
cad/solidworks/05_Comerciales/CB-505_Motor_NEMA17_Prismatico.SLDPRT
cad/solidworks/05_Comerciales/Electronica/CB-510_Sabertooth_2x60.SLDPRT
cad/solidworks/05_Comerciales/Tornilleria/HW_M4x40.SLDPRT
cad/solidworks/09_Herramienta/CB-614_Horn_Servo_D20.SLDPRT
entregas/entrega_07/Eslabon.stl
simulink/brazo_telescopico/CB-516_Microswitch_Palanca_19.8x6.4_Default_sldprt.STEP
cad/herramienta/stl/EjeHueco_Polea.stl
cad/imprimir/00_Herramienta/CB-605_Polea_Servo_GT2.stl
cad/imprimir/01_Base_J0/CB-153_Cabezal_Mastil.stl
cad/imprimir/11_v7B_Prismatico_Telescopico/CB-413B_Soporte_Polea_Delantera.stl
cad/solidworks/01_Base_J0/CB-141_Bandeja_Electronica.SLDPRT
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
