pajagua/recolector-de-frutas/cad/solidworks/06_Imagenes/CB-159_Camaras_Prueba_Tripode_trimetric.png

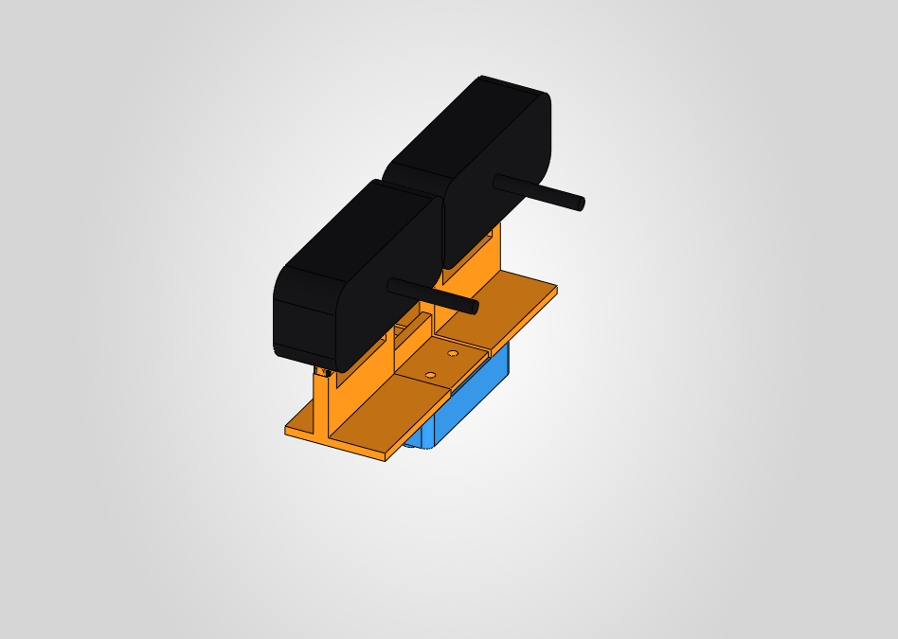
cad/solidworks/06_Imagenes/CB-159_Camaras_Prueba_Tripode_trimetric.png
