pajagua/recolector-de-frutas/vision/config/camaras.yaml

camaras:
  izq: 0          # índice de la webcam izquierda
  der: 1          # índice de la webcam derecha
  ancho: 1280
  alto: 720
  fps: 30

tablero:
  columnas: 9     # esquinas internas
  filas: 6
  cuadro_mm: 25.0 # lado real de cada cuadro impreso

# Montaje (CAD: cad/solidworks/01_Base_J0/CB-150_Modulo_Camaras.SLDASM). Valores nominales del CAD, para arrancar;
# la calibración estéreo y la cámara -> robot dan los reales.
# Marco "árbol": origen en el eje J1 sobre la cara del tablero, x hacia el árbol, y lateral, z arriba (mm).
montaje:
  linea_base_mm: 71.0                   # distancia entre lentes (soporte StereoVision_03), cámaras paralelas
  lente_izq_mm: [2.1, 143.9, 661.1]      # aprox.: la posición de la C270 en su pinza no está medida (v7.7)
  lente_der_mm: [-17.0, 75.5, 661.1]
  eje_optico: [0.6949, -0.1943, -0.6924] # rumbo -15.6°, 43.8° hacia abajo, apunta al centro de la esfera
  centro_esfera_mm: [385.0, 0.0, 270.0]  # esfera de trabajo de 300 mm (docs/espacio_de_trabajo.md)
