pajagua/recolector-de-frutas/(commit log)

2026-10-21 Estructura inicial del repositorio CitriBot
    - CAD: ensamblaje SolidWorks v5 del brazo con herramienta (Git LFS)
    - Herramienta: fuente OpenSCAD y STL
    - BOM completa con préstamos del laboratorio y compras del grupo
    - Esqueleto de firmware (PlatformIO), visión y control
    - Documentación de arquitectura y entregas 5 y 6
    [2M1D_original_usuario.STEP, AcopleManguera.stl, Anclaje Horquilla.dxf, AnilloDeRetencion.stl, BOM_CitriBot.csv, BOM_CitriBot.xlsx, CB-000_CitriBot_Ensamblaje_General.SLDASM, CB-000_CitriBot_Ensamblaje_General.step]
2026-10-21 Entrega 7: piezas modificadas del prototipo con GA25-370
    Solo piezas del grupo. Las originales del diseño Mrk1 y la placa
    AcopleNemaGA.3mf (que las incluye) quedan fuera del repo público.
    [AxeSortie.3mf, Axe_Sortie_Reforzado.stl, Base.3mf, Base.stl, BaseSimple.3mf, Brazo3Ejes_GA25.stl, EngranajeSol.3mf, EngranajeSol.stl]
2026-10-23 CAD v6: J3 de 350 mm para cubrir la esfera de trabajo y motor del hombro según plano
    - Prismático J3 nuevo: E2 cortado a 93 mm del eje J2 con cola de 55 x 55,
    tubo de aluminio 30x30x2 de 460 mm que se retrae por detrás del hombro,
    NEMA 17 + husillo T8 de 400 mm. Carrera 350 mm: la ventosa va de 227.8 a
    577.8 mm del eje J2 y cubre el 100 % de la esfera (necesita 254 a 554 mm).
    - J2 libre de -45 a +45 grados con el brazo hacia el árbol (necesita -34 a +10).
    - Motor del hombro (5840) rehecho con el plano del vendedor: rosca M4 (no M6),
    resaltes de apoyo de 2 mm, buje D18.5 x 5. Torre con agujeros M4 y tornillos
    M4x10; relación J2_eje_hombro rehecha. Sin choques con la torre ni co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
    [BOM_CitriBot.csv, BOM_CitriBot.xlsx, CB-000_CitriBot_Ensamblaje_General.SLDASM, CB-000_CitriBot_Ensamblaje_General.step, CB-200_Cintura_J1.SLDASM, CB-210_Torre_Cintura_2M1D_mod.SLDPRT, CB-300_Hombro_E2_J2.SLDASM, CB-301_Eslabon_E2_mod5840.SLDPRT]
2026-10-27 CAD v7: J3 con correa GT2 (cola 377 mm) y mástil de cámaras estéreo
    Prismático J3 (variante A, pasa al ensamblaje principal):
    - E3: tubo 30x30x2 de 440 mm movido por un lazo de correa GT2
    (polea 20T en el NEMA 17, polea loca 20T en la punta de la cola).
    - NEMA 17 vertical sobre el cubo de E2 (placa CB-306 con insertos M3).
    - Cola de E2 a 377 mm detrás de J2 (antes 451.5 con el motor). Carrera 340 mm.
    - Salen husillo T8, tuerca, acople y portatuerca; entran CB-403 tapón con
    pinza, CB-514 correa y poleas GT2. Brida y tapón con pasadores al ras.
    - Variante B (telescópica 2:1) queda como alternativa en
    11_v7B_Prismatico_Telescopico y CB-000B. Comparación: docs/v7_prismatico.md.
    -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
    [BOM_CitriBot.csv, BOM_CitriBot.xlsx, CB-000B_CitriBot_v7B_Telescopico.SLDASM, CB-000_CitriBot_Ensamblaje_General.SLDASM, CB-000_CitriBot_Ensamblaje_General.step, CB-100_Base_J0.SLDASM, CB-150_Modulo_Camaras.SLDASM, CB-151_Pie_Mastil_Camaras.SLDPRT]
2026-10-29 CAD v7.1-v7.2: soporte estéreo StereoVision_03 y ventosa JXD en el eje hueco
    - Cámaras: el soporte StereoVision_03 del usuario (base CB-156 remodelada con
    4 agujeros M3, tapa CB-157) va sobre el adaptador CB-154 en el cabezal del
    mástil; base estéreo de 71 mm. Salen la barra CB-154 y el soporte CB-155.
    Pieza de pruebas CB-158 con bola Ø11,8 para la rótula del trípode y
    conjunto CB-159.
    - Herramienta: la punta de CB-606 toma la parte de arriba de la ventosa JXD
    medida (Ø19 con planos a 17) en un alojamiento doble D, así la torsión gira
    la ventosa. El racor 6 mm × G1/4 baja por dentro del eje, apoya en un fondo
    de 3 mm y aprieta la ventosa contra él. Nuevos CB-618 (ve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
    [BOM_CitriBot.csv, BOM_CitriBot.xlsx, CB-000_CitriBot_Ensamblaje_General.step, CB-150_Modulo_Camaras.SLDASM, CB-154_Adaptador_Soporte_Estereo.SLDPRT, CB-154_Adaptador_Soporte_Estereo.stl, CB-154_Barra_Estereo.SLDPRT, CB-155_Soporte_C270.SLDPRT]
2026-10-29 Imprimir: un STL por pieza, en carpetas como el CAD
    - cad/imprimir separado por subconjunto como cad/solidworks; la herramienta
    va primero (00_Herramienta = 09_Herramienta del CAD).
    - STL nuevos de todas las piezas impresas de la BOM que faltaban (base,
    cintura, hombro, prismático y herramienta); se mueven los que ya estaban.
    - README de imprimir con cantidades y notas por pieza. CB-210 (318 mm de
    alto) y CB-301 (470 mm de largo) no entran en la Ender 3 V2.
    - Rutas de los STL corregidas en la BOM, el README del CAD y el de visión.
    - Script ExportStl.cs para volver a exportarlos.
    [BOM_CitriBot.csv, BOM_CitriBot.xlsx, CB-112_Pata_Base.stl, CB-121_Placa_Fija_J1_1M2A.stl, CB-131_Soporte_Motor_J1_37D.stl, CB-141_Bandeja_Electronica.stl, CB-151_Pie_Mastil_Camaras.stl, CB-153_Cabezal_Mastil.stl]
2026-10-30 Herramienta: ranura para el cable del servo de torsión y guía de montaje
    - CB-602 porta-servo: ranura de 6,6 mm en la pared del lado del cable para
    que entre el MG996R de torsión con su pasacables; los agujeros de las
    orejas de ese lado se corren 0,6 mm hacia afuera. El cable sale por la
    muesca que ya tenía la caja CB-603. STL nuevo en cad/imprimir.
    - docs/montaje_herramienta.md: orden de armado de CB-600, tornillería y
    lámina con la vista explotada rotulada y la herramienta armada.
    - README del CAD (§6.13), BOM e imprimir actualizados; script CableServo.cs.
    [BOM_CitriBot.csv, BOM_CitriBot.xlsx, CB-602_Porta_Servo.SLDPRT, CB-602_Porta_Servo.stl]
2026-11-02 CAD v7.7: tablero de 400 x 300 y herramienta para el horn de plástico medido
    - Base: tablero CB-111 de 400 x 300 x 16 (reemplaza al 550 x 550 del BCN3D).
    J1 a 185 mm del borde del árbol. Bandeja de electrónica al costado, mástil de
    las cámaras en la esquina trasera y re-apuntado, patas en las esquinas nuevas.
    J1 libre de -70° a +100°; márgenes de alcance 17 / 24 mm; carro del riel hasta 77 mm.
    - Herramienta: asiento del horn de plástico del MG996R (Ø21, resalte 8.5 x 1,
    agujeros en Ø14.5) en CB-603 y CB-605; pestañas del servo de muñeca en 9 x 49
    con tuerca atrapada en CB-601. STL regenerados. .scad v4.3 con las medidas reales.
    - Scripts Base3040.cs y Horn21.cs; SweepJ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
    [AnilloDeRetencion.stl, BOM_CitriBot.csv, BOM_CitriBot.xlsx, Body1.SLDPRT, Body2.SLDPRT, CB-000_CitriBot_Ensamblaje_General.SLDASM, CB-001_Brazo_Solo.SLDASM, CB-100S_Base_Brazo.SLDASM]
2026-11-07 CAD v7.8-v7.11: finales de carrera, PCA9685, J1 centrado y revisión de uniones
    - v7.8: prismático telescópico solo (CB-450B) con estudio de movimiento y
    CB-420B; documentos de opciones del prismático y lista de la variante B.
    - v7.9: J1 en el centro del tablero de 400 x 300; patas y bandeja corridas.
    - v7.10: revisión de uniones atornilladas de la base, la cintura, el motor de
    J1 y la electrónica. CB-121: agujeros de los ejes de los 4 rodillos
    diagonales. CB-201: rebaje de la cabeza del M8 a Ø16.
    - v7.11: finales de carrera (microswitch con palanca CB-516). J1: leva en la
    base de la torre CB-210 y poste CB-161 (home en -67°). J3: escuadra CB-307
    en el fondo del canal de E2,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
    [BOM_CitriBot.csv, BOM_CitriBot.xlsx, CB-000_CitriBot_Ensamblaje_General.SLDASM, CB-001_Brazo_Solo.SLDASM, CB-100S_Base_Brazo.SLDASM, CB-100_Base_J0.SLDASM, CB-110_Base_Tablero_Patas.SLDASM, CB-111_Tablero_Madera_400x300x16.SLDPRT]
2026-11-07 version casi final
    [CB-121_Placa_Fija_J1_1M2A_Predeterminado_sldprt.STEP, CB-201_Plato_Giratorio_Polea_J1_1M1B_Predeterminado_sldprt.STEP, CB-210_Torre_Cintura_2M1D_mod_Default_sldprt.STEP, CB-232_Soporte_Iman_J2_Default_sldprt.STEP, CB-301_Eslabon_E2_mod5840_Predeterminado_sldprt.STEP, CB-303_Tapa_E2_Soporte_AS5600_Default_sldprt.STEP, CB-305_Buje_D8_Hombro_Default_sldprt.STEP, CB-306_Placa_Soporte_NEMA17_Prismatic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]
2026-11-07 CAD v7.12: el prismático telescópico pasa a ser el diseño oficial
    - CB-000_CitriBot_Ensamblaje_General es ahora el robot con el
    telescópico 2:1 (era CB-000B_CitriBot_v7B_Telescopico). La variante A
    (correa y un tubo de 440 mm) queda como alternativa en
    CB-000A_CitriBot_v7A_Correa, con sus piezas de siempre.
    - Lo que tenía solo la A pasa a la B: final de carrera de J3 en un
    alojamiento detrás de la pared trasera de E2-B (CB-301B, 2 x M2x12; lo
    aprieta el tapón del intermedio CB-412B en home) y sistemas de
    referencia DH SR2 en CB-301B y SR3 en CB-421B (copiados de CB-301 y
    CB-401, misma transformación). Script Telescopico.cs.
    - BOM: tubos de 275 mm (30 x 30) y 263 mm (20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
    [BOM_CitriBot.csv, BOM_CitriBot.xlsx, CB-000A_CitriBot_v7A_Correa.SLDASM, CB-000B_CitriBot_v7B_Telescopico.SLDASM, CB-000_CitriBot_Ensamblaje_General.SLDASM, CB-300B_Hombro_E2_v7B.SLDASM, CB-301B_Eslabon_E2_v7B_Telescopico.SLDPRT, CB-301B_Eslabon_E2_v7B_Telescopico.stl]
2026-11-07 CB-001 (brazo solo) con el prismático telescópico
    - CB-001 se vuelve a copiar de CB-000 (telescópico) con copias nuevas
    CB-300BS (E2 sin el NEMA 17) y CB-400BS (tramo interior con la
    herramienta sin servos); reusa CB-100S, CB-200S y CB-600S, y el tramo
    intermedio CB-410B es el original. La relación de J2 se rehace contra el
    imán del AS5600, como antes. 121 componentes y 10 relaciones sin errores.
    - Se borran las copias de la variante A (CB-300S y CB-400S).
    - BrazoSolo.cs: modo `telescopico`.
    - La exportación a Simscape de simulink/ es de antes (variante A).
    [CB-001_Brazo_Solo.SLDASM, CB-300BS_Hombro_E2_v7B_Sin_Motor.SLDASM, CB-300S_Hombro_E2_J2_Sin_Motor.SLDASM, CB-400BS_Prismatico_E3_v7B.SLDASM, CB-400S_Prismatico_E3_J3.SLDASM]
2026-11-11 Simscape: modelo del brazo solo con la variante A (correa), antes del telescópico
